frozenframework/Pi4B_HeadUnit/apps/styles/hudiy-bg/after-midnight.jpg

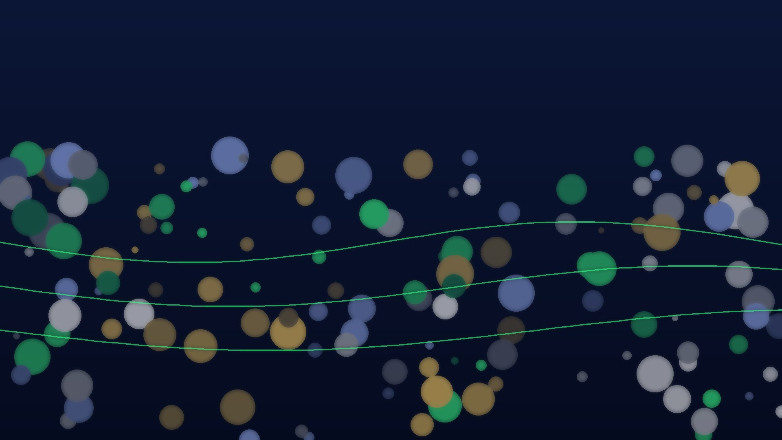
apps/styles/hudiy-bg/after-midnight.jpg
