frozenframework/Pi4B_HeadUnit/apps/styles/hudiy-bg/neon-overdrive.jpg

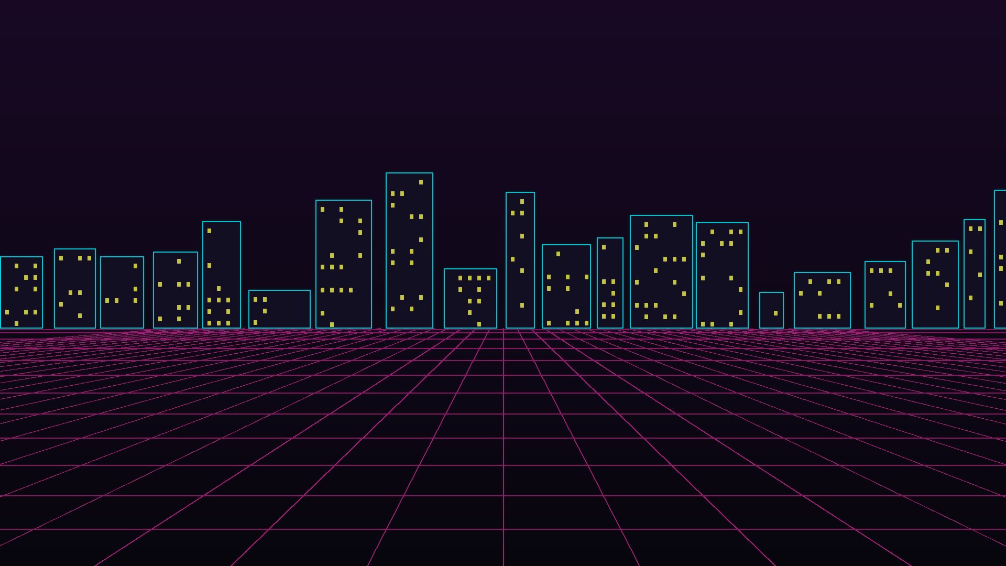
apps/styles/hudiy-bg/neon-overdrive.jpg
