frozenframework/Pi4B_HeadUnit/apps/styles/hudiy-bg/street-heat.jpg

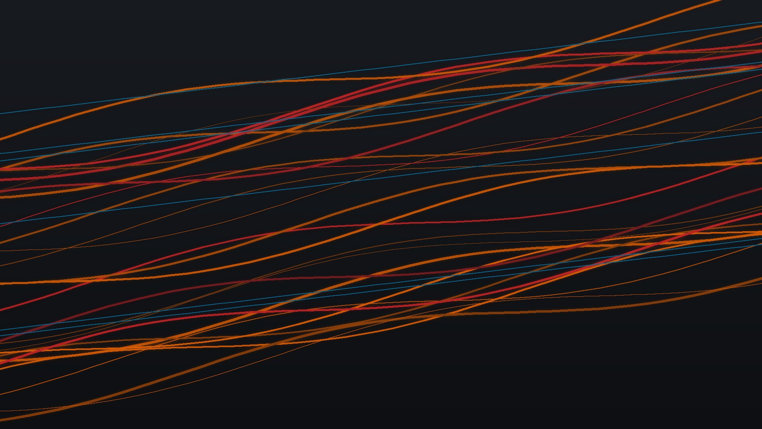
apps/styles/hudiy-bg/street-heat.jpg
