frozenframework/Pi4B_HeadUnit/apps/styles/hudiy-bg/sunset-junction.jpg

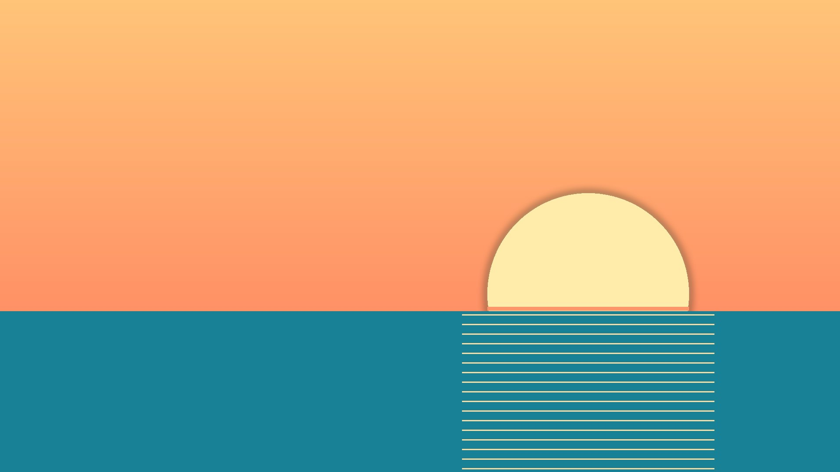
apps/styles/hudiy-bg/sunset-junction.jpg
