frozenframework/Pi4B_HeadUnit/apps/theme/previews/after-midnight.png

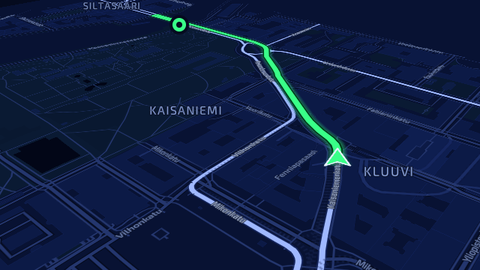
apps/theme/previews/after-midnight.png
