frozenframework/Pi4B_HeadUnit/apps/theme/previews/neon-overdrive.png

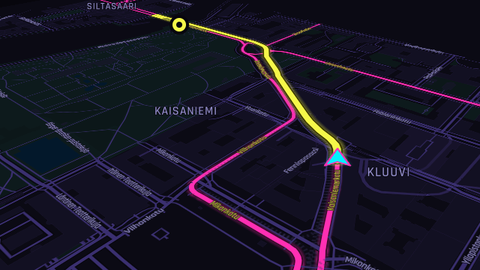
apps/theme/previews/neon-overdrive.png
