frozenframework/Pi4B_HeadUnit/apps/theme/previews/street-heat.png

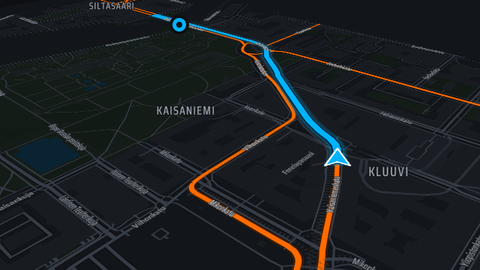
apps/theme/previews/street-heat.png
