frozenframework/Pi4B_HeadUnit/apps/theme/previews/sunset-junction.png

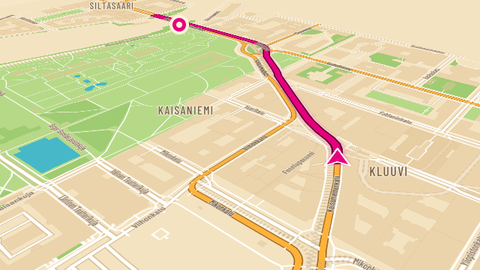
apps/theme/previews/sunset-junction.png
