frozenframework/Pi4B_HeadUnit/docs/Frontier_2DIN_Parts_List.xlsx

Sheet: Summary
2017 Frontier SV: budget tiers
Prices checked 2026-10-30/31. Totals exclude the Pi 4B and microSD you already have.
Tier | Budget target ($) | Parts total ($) | Over (+) / under (-) ($) | What you get
Tier 1 | $100.00 | $246.29 | $146.29 | Double-DIN install, Raspberry Pi Touch Display 2, Android Auto (wired or wireless, built into Hudiy), iPod/USB music, safe-shutdown power, 4-speaker amp. No CarPlay, no camera, no GPS navigation, no wheel buttons.
Tier 2 | $250.00 | $414.23 | $164.23 | Tier 1 plus CarPlay (Carlinkit), the factory backup camera (Axxess adapter + capture stick, shows automatically in reverse), GPS for the themed offline navigation, and a powered USB hub.
Tier 3 | $500.00 | $498.66 | -$1.34 | Your chosen spec: 900-nit Orient Display instead of the Touch Display 2, steering-wheel controls (MCP3008), noise isolation, cooling case and trim tools.
Why Tier 1 can't hit $100: the dash kit ($26.99), harness ($20.49) and the cheapest suitable 7in touchscreen (about $82-88 in 2026) are about $130 before power or audio parts.
Why Tier 2 runs over: CarPlay needs the $65 Carlinkit, and keeping the factory camera is about $64 (Axxess 6 V adapter + USB capture stick + cable).
Biggest levers: skip CarPlay (-$65) or the camera (-$64). The safe-shutdown power latch (about $54) protects the SD card and isn't worth cutting.
Legend: blue = editable input. Green = pulled from another sheet. Red delta = over budget.

Sheet: Frontier Parts
2017 Nissan Frontier SV: double-DIN Pi 4B head unit, three budget tiers
Base audio (no sub), factory camera, Pi already owned. Tier columns: Y = included. ALT / OPT / HAVE rows aren't counted. Blue cells are editable (qty, price, Y flags, budget). Gray Price Basis = estimate.
# | Group | Item | Model / Part # | Why it's needed | Qty | Unit Price ($) | Price Basis | Tier 1 | Tier 2 | Tier 3 | Tier 1 Cost ($) | Tier 2 Cost ($) | Tier 3 Cost ($) | Vendor | URL | Notes
1 | 1. Double-DIN install | Dash kit, single/double-DIN (most 2017 Frontier trims) | Metra 99-7581 | Gives the dash a standard ISO double-DIN opening to anchor the screen bezel and Pi sled. | 1 | $26.99 | Verified 2026-10-30 | Y | Y | Y | $26.99 | $26.99 | $26.99 | OnlineCarStereo (Metra) | https://onlinecarstereo.com/CarAudio/p_22709_Metra_Electronics_99-7581.aspx | The kit for your SV. Listed for Frontier/Pathfinder/Xterra 2005-2017; double-check in Metra's Vehicle Fit Guide when ordering.
2 | 1. Double-DIN install | Radio wiring harness with amp integration + reverse lead | Metra 70-7552 | Plugs into the factory radio plug. Works with the base system and the Rockford Fosgate amplified system, and has a reverse-signal wire for the camera trigger. | 1 | $20.49 | Verified 2026-10-30 | Y | Y | Y | $20.49 | $20.49 | $20.49 | OnlineCarStereo (Metra) | https://onlinecarstereo.com/CarAudio/p_22955_Metra_Electronics_70-7552.aspx | On sale for $10.99 when checked; regular price used. No ground wire: ground to chassis.
3 | 1. Double-DIN install | Radio removal / trim tool set | Generic | Pops the center bezel without marring it. | 1 | $9.00 | Estimate |  |  | Y | $0.00 | $0.00 | $9.00 | Amazon (search) | https://www.amazon.com/s?k=car+trim+removal+tool+kit | Skip if you already own one.
4 | 2. Screen (2-DIN) | 7in 1024x600 HDMI + USB capacitive touch, 900 nits | Orient Display AFY1024600A2-7.0INTH-C-HDMI | Bright enough for a truck dash in Texas sun; rated -20 to 70 C; runs off 12 V directly. | 1 | $107.88 | Verified 2026-10-31 |  |  | Y | $0.00 | $0.00 | $107.88 | Orient Display | https://orientdisplay.com/products/7-0-raspberry-pi-tft-with-pcap-1024x600-900-nits-vga-hdmi-usb-interface/ | Module about 165 x 116 x 12 mm: the printed 2-DIN bezel sits over the kit opening. Measure before printing.
5 | 2. Screen (2-DIN) | Raspberry Pi Touch Display 2 (7in, 720x1280 DSI) | SC1635 | Budget alternative INSTEAD of the Orient Display: official, plugs into the DSI port, powered by the Pi. | 1 | $81.95 | Verified 2026-10-31 | Y | Y |  | $81.95 | $81.95 | $0.00 | PiShop.us | https://www.pishop.us/product/raspberry-pi-touch-display-2/ | Dimmer than 900 nits (brightness not published). 189 x 120 mm outline. Set DISPLAY_TYPE=pi-touch-display-2. Tiers 1-2 screen: DSI ribbon, powered by the Pi; set DISPLAY_TYPE=pi-touch-display-2.
6 | 2. Screen (2-DIN) | Micro-HDMI to HDMI cable, 30 cm, slim | Generic | Pi 4 micro-HDMI to the screen. | 1 | $9.00 | Estimate |  |  | Y | $0.00 | $0.00 | $9.00 | Amazon (search) | https://www.amazon.com/s?k=micro+HDMI+to+HDMI+30cm+slim
7 | 3. Factory backup camera | Backup-camera retention harness with 6 V converter | Axxess AXBUCS-NI326V | Connects the factory Nissan camera to an aftermarket head unit and powers it with the 6 V it needs. | 1 | $42.94 | Verified 2026-10-31 |  | Y | Y | $0.00 | $42.94 | $42.94 | OnlineCarStereo (Axxess) | https://www.onlinecarstereo.com/CarAudio/p_79967_Axxess_AXBUCS-NI326V.aspx | Listed for Frontier 2013-up. Only for trucks that came with a camera (factory screen radio).
8 | 3. Factory backup camera | USB composite-video capture stick (UTV007 / STK1160 chip) | EasyCap-style | The Pi has no video input; this turns the camera's RCA signal into a USB webcam Hudiy can show. | 1 | $15.00 | Estimate |  | Y | Y | $0.00 | $15.00 | $15.00 | Amazon (search) | https://www.amazon.com/s?k=USB+video+capture+UTV007+composite | Pick one that names UTV007 or STK1160 (both have Linux drivers built in).
9 | 3. Factory backup camera | RCA video extension, 1 m | Generic | Camera harness RCA to the capture stick behind the dash. | 1 | $6.00 | Estimate |  | Y | Y | $0.00 | $6.00 | $6.00 | Amazon (search) | https://www.amazon.com/s?k=RCA+video+cable+3ft
10 | 4. Head unit core | Hudiy head-unit license | Hudiy 2.x | CarPlay (via Carlinkit) + Android Auto. One license per vehicle. | 1 | $10.00 | Verified 2026-10-30 | Y | Y | Y | $10.00 | $10.00 | $10.00 | Hudiy | https://hudiy.eu/product/hudiy/
11 | 4. Head unit core | Carlinkit CPC200-CCPA wireless CarPlay / Android Auto adapter | CPC200-CCPA | Required for CarPlay. | 1 | $65.00 | Verified 2026-10-30 |  | Y | Y | $0.00 | $65.00 | $65.00 | Carlinkit | https://carlinkitcarplay.com/products/carlinkit-wirless-adapter-for-android-head-unit-support-carplay-and-android-auto
12 | 5. Power | 12V to 5V 5A step-down, USB-C | Generic | Pi power. | 1 | $14.00 | Estimate | Y | Y | Y | $14.00 | $14.00 | $14.00 | Amazon (search) | https://www.amazon.com/s?k=12V+to+5V+5A+USB-C+step+down+converter | 8-36 V input range.
13 | 5. Power | 12V 40A SPDT relay with socket | Bosch-style | Main power latch (key on / Pi holds until clean shutdown). | 1 | $8.00 | Estimate | Y | Y | Y | $8.00 | $8.00 | $8.00 | Amazon (search) | https://www.amazon.com/s?k=12V+40A+SPDT+relay+socket+harness
14 | 5. Power | 4-channel 5V relay module, HIGH-level trigger | Generic | CH1 power hold, CH2 amp remote, CH3 antenna-amp feed, CH4 spare. | 1 | $9.00 | Estimate | Y | Y | Y | $9.00 | $9.00 | $9.00 | Amazon (search) | https://www.amazon.com/s?k=4+channel+5V+relay+module+optocoupler+high+level+trigger
15 | 5. Power | 4-channel optocoupler module, 12V in / 3.3V out | PC817 based | ACC (ignition), dash lights, REVERSE (camera trigger), spare. The Frontier needs the extra reverse channel. | 1 | $9.00 | Estimate | Y | Y | Y | $9.00 | $9.00 | $9.00 | Amazon (search) | https://www.amazon.com/s?k=PC817+4+channel+optocoupler+isolation+module+12V+3.3V | Replaces the 2-channel module used in the F-250/Miata lists.
16 | 5. Power | 1N4007 diode pack + inline ATC fuse holders | Generic | Diode-OR for the relay coil; fuse every 12 V feed. | 1 | $14.00 | Estimate | Y | Y | Y | $14.00 | $14.00 | $14.00 | Amazon (search) | https://www.amazon.com/s?k=inline+ATC+fuse+holder+16AWG+kit
17 | 6. Audio | USB audio adapter (3.5 mm out) | Adafruit 1475 | Clean line out to the amp. | 1 | $4.95 | Verified 2026-10-30 | Y | Y | Y | $4.95 | $4.95 | $4.95 | Adafruit | https://www.adafruit.com/product/1475
18 | 6. Audio | TPA3116D2 2x50W amp board | Parts Express 320-699 | Your SV has the base (non-Rockford) audio: the two boards drive the 4 door speakers directly. | 2 | $13.98 | Verified 2026-10-30 | Y | Y | Y | $27.96 | $27.96 | $27.96 | Parts Express | https://parts-express.com/TPA3116D2-2x50W-Class-D-Stereo-Amplifier-Board-with-Volume-Control-320-699 | Print an ASA enclosure; the 2-DIN sled has room for both boards.
19 | 6. Audio | RCA Y-splitter pair | Generic | Front + rear from one stereo output. | 1 | $6.00 | Estimate | Y | Y | Y | $6.00 | $6.00 | $6.00 | Amazon (search) | https://www.amazon.com/s?k=RCA+Y+splitter+1+female+2+male
20 | 6. Audio | Ground loop noise isolator | Generic | Kills alternator whine. | 1 | $10.00 | Estimate |  |  | Y | $0.00 | $0.00 | $10.00 | Amazon (search) | https://www.amazon.com/s?k=ground+loop+noise+isolator+car+audio
21 | 6. Audio | Mini USB microphone | Adafruit 3367 | Siri / Google Assistant / calls. | 1 | $5.95 | Verified 2026-10-30 | Y | Y | Y | $5.95 | $5.95 | $5.95 | Adafruit | https://www.adafruit.com/product/3367
22 | 7. Nav, media, cooling | USB GPS receiver (u-blox 7) | VK-162 | Themed offline navigation. | 1 | $14.00 | Estimate |  | Y | Y | $0.00 | $14.00 | $14.00 | Amazon (search) | https://www.amazon.com/s?k=VK-162+USB+GPS
23 | 7. Nav, media, cooling | Powered USB 2.0 hub (5 V input) | Generic | Dongle, GPS, capture stick, iPod, mic exceed the Pi's 1.2 A USB budget. | 1 | $15.00 | Estimate |  | Y | Y | $0.00 | $15.00 | $15.00 | Amazon (search) | https://www.amazon.com/s?k=powered+USB+2.0+hub+5V+DC+input+4+port
24 | 7. Nav, media, cooling | 12V to 5V 3A step-down (hub feed) | Generic | Powers the USB hub. | 1 | $10.00 | Estimate |  | Y | Y | $0.00 | $10.00 | $10.00 | Amazon (search) | https://www.amazon.com/s?k=12V+to+5V+3A+step+down+converter+module | The Orient Display runs on 12 V, so this only feeds the hub.
25 | 7. Nav, media, cooling | USB panel-mount extension (iPod / USB stick) | Generic | Front-accessible USB for the iPod. | 1 | $8.00 | Estimate | Y | Y | Y | $8.00 | $8.00 | $8.00 | Amazon (search) | https://www.amazon.com/s?k=USB+2.0+panel+mount+extension+cable+female
26 | 7. Nav, media, cooling | Pi 4 heatsink case with fan | Armor-style | Cooling in a hot dash. | 1 | $10.00 | Estimate |  |  | Y | $0.00 | $0.00 | $10.00 | Amazon (search) | https://www.amazon.com/s?k=Raspberry+Pi+4+aluminum+armor+case+fan
27 | 8. Steering-wheel controls | MCP3008 8-channel 10-bit ADC | Adafruit 856 | Reads the wheel's resistor-ladder buttons. hu-swc.py learns your buttons and sends volume/track/phone actions to Hudiy. | 1 | $4.50 | Verified 2026-10-31 |  |  | Y | $0.00 | $0.00 | $4.50 | Adafruit | https://www.adafruit.com/product/856 | SPI bus (GPIO 8-11): no clash with the ignition, reverse or power pins.
28 | 8. Steering-wheel controls | 1 kOhm 1/4 W resistor assortment | Generic | Pull-up for each wheel key wire (one per channel used). | 1 | $6.00 | Estimate |  |  | Y | $0.00 | $0.00 | $6.00 | Amazon (search) | https://www.amazon.com/s?k=1k+ohm+resistor+1/4W+pack
29 | 8. Steering-wheel controls | Proto HAT / perfboard for the ADC + resistors | Adafruit Perma-Proto HAT or generic | Solid mount for the MCP3008, pull-ups and the opto board connections on the Pi header. | 1 | $10.00 | Estimate |  |  | Y | $0.00 | $0.00 | $10.00 | Amazon (search) | https://www.amazon.com/s?k=Raspberry+Pi+proto+HAT+perfboard | Leave the CarPiHAT out on this truck; this board uses the same header.
 |  |  |  |  |  |  |  |  |  | Tier total | $246.29 | $414.23 | $498.66
 |  |  |  |  |  |  |  |  |  | Budget target | $100.00 | $250.00 | $500.00
 |  |  |  |  |  |  |  |  |  | Over (+) / under (-) | $146.29 | $164.23 | -$1.34
Alternatives, optional add-ons and parts you already have (not counted)
# | Group | Item | Model / Part # | Why | Qty | Unit Price ($) | Price Basis | Status | URL | Notes
1 | 1. Double-DIN install | Dash kit, double-DIN (SL with Comfort & Convenience pkg - NOT your SV) | Metra 95-7619 | Not for your SV. Listed for reference: SL with Comfort & Convenience package only. | 1 | $29.99 | Verified 2026-10-31 | ALT | https://www.soundoftristate.com/metra-95-7619 | Metra lists this kit for 2013+ Frontier SL with comfort & convenience package only.
2 | 1. Double-DIN install | Antenna adapter (Nissan 2007+) | Metra 40-NI12 | Factory antenna plug to the standard Motorola plug (for the RTL-SDR radio adapter if you add AM/FM). | 1 | $9.99 | Verified 2026-10-31 | OPT | https://www.qualitymobilevideo.com/40-ni12.html | Only needed if you add the AM/FM tuner (RTL-SDR).
3 | 4. Head unit core | Raspberry Pi 4 Model B, 4 GB | SC0195 | You have a third Pi 4: not counted. | 1 | $80.00 | Estimate | HAVE | https://www.pishop.us/product/raspberry-pi-4-model-b-4gb/ | Price rose in 2026 (memory costs): about $55 + $25.
4 | 4. Head unit core | 32 GB microSD (you have) or 256 GB High Endurance for whole-US maps | SanDisk SDSQQNR-256G | Texas + neighbors fits on 32 GB; whole US needs the 256 GB card. | 1 | $25.00 | Estimate | OPT | https://www.amazon.com/s?k=SanDisk+High+Endurance+256GB+microSD
5 | 8. Optional | AM/FM: RTL-SDR Blog V4 + Motorola-to-SMA adapter | R828D | Adds AM/FM like the F-250 tier 3. | 1 | $49.00 | Estimate | OPT | https://www.rtl-sdr.com/product/rtl-sdr-blog-v4-r828d-rtl2832u-1ppm-tcxo-sma-software-defined-radio-dongle-only-usb-c/ | Needs the Metra 40-NI12 too.

Sheet: Wiring Frontier
Wiring: Metra 70-7552 harness, factory camera, Pi GPIO
Metra's colors follow the EIA standard. The 70-7552 sheet lists its extra leads (amp integration, reverse, steering wheel): confirm each with a meter (key off, key on, in reverse, lights on).
Harness wire | Function | Connects to (head unit side) | Fuse / gauge | Notes
Yellow | +12 V constant | Fuse 7.5 A -> main relay pin 30 and relay-module CH1 COM (power hold) | 7.5 A, 16 AWG
Red | +12 V accessory | Diode D1 -> main relay coil 86; optocoupler CH1 -> GPIO3 (ACC sense + wake) | 2 A, 18 AWG
Black / chassis | Ground | Relay 85, converters, amp boards, screen | 16 AWG | Harness has no ground wire: bolt to bare chassis metal behind the dash.
Orange (or Orange/White) | Dash illumination | Optocoupler CH2 -> GPIO4 (night dimming) | 1 A, 18 AWG
Reverse lead (see 70-7552 sheet) | +12 V in reverse | Optocoupler CH3 -> GPIO5 -> Hudiy shows the camera | 1 A, 18 AWG | If the harness lead is dead in reverse, tap the reverse-light feed instead.
Blue/White | Amp turn-on | Not needed on your SV (no factory amp): leave capped | - | The TPA boards switch with the relay instead.
Blue | Antenna amp power | Relay 87 switched 12 V (always on with the head unit) | 1 A, 18 AWG | Powers the antenna amplifier on Nissans; only matters for AM/FM.
TPA3116 board power | 12 V for the amp boards | Relay 87 switched 12 V via 5 A fuse | 5 A, 16 AWG | Boards power up only after the Pi has booted (relay CH2), so no turn-on pop.
White / White-Black | Left front + / - | Amp CH1 L | 18 AWG
Gray / Gray-Black | Right front + / - | Amp CH1 R | 18 AWG
Green / Green-Black | Left rear + / - | Amp CH2 L | 18 AWG | Crew cab rear doors.
Violet / Violet-Black | Right rear + / - | Amp CH2 R | 18 AWG
Steering-wheel key wires (70-7552 SWC leads) | Resistor-ladder buttons | Each key wire -> MCP3008 CH0, CH1... and a 1 kOhm pull-up to 3.3 V | - | Find them with a meter: resistance to the wheel-control ground changes as you press buttons. Then run hu-swc.py --raw to check, --learn to record.
Steering-wheel ground | Ladder return | Pi GND | - | Must share ground with the Pi, or the readings drift.
MCP3008 VDD + VREF | ADC supply / reference | Pi 3.3 V (pin 1) | - | 3.3 V reference = same rail as the pull-ups, so readings stay ratiometric.
MCP3008 CLK / DOUT / DIN / CS | SPI | GPIO11 (pin 23) / GPIO9 (pin 21) / GPIO10 (pin 19) / GPIO8 (pin 24) | - | dtparam=spi=on is set by setup stage 77-swc.
Axxess AXBUCS-NI326V | Factory camera | Camera plug -> harness; 6 V converter powered from the REVERSE lead; RCA video -> USB capture stick | - | Camera gets power only in reverse, same as the factory radio did.
Pi GPIO3 (pin 5) | ACC sense / wake | Optocoupler CH1 output | -
Pi GPIO4 (pin 7) | Dash lights | Optocoupler CH2 output | -
Pi GPIO5 (pin 29) | Reverse | Optocoupler CH3 output | - | New for the Frontier.
Pi GPIO26 (pin 37) | Power hold | Relay module IN1 | - | gpio-poweroff overlay
Pi GPIO27 (pin 13) | Amp remote | Relay module IN2 | -
Orient Display 12 V | Screen power | Relay 87 switched 12 V via 2 A fuse | 2 A, 18 AWG | This screen runs on 12 V directly.

Sheet: Your answers
Your answers (2026-10-31) and what they changed
Trim: SV | Dash kit Metra 99-7581 (the 95-7619 is SL-only). SV has wheel audio buttons: steering-wheel parts added.
Rockford Fosgate: no (no sub) | Base audio: amp boards drive the 4 door speakers directly; harness amp-integration and amp turn-on leads stay unused.
Factory camera: yes | Axxess AXBUCS-NI326V + USB capture stick; camera shows automatically in reverse.
Screen: 900-nit Orient Display | Runs on 12 V; printed 2-DIN bezel (cad/print/2din-7in). Measure the module before printing.
Steering-wheel controls: yes | MCP3008 + 1 kOhm pull-ups; run hu-swc.py --learn once with the key on.
Third Pi 4: already have | Pi not counted in the total.
