frozenframework/Pi4B_HeadUnit/docs/Pi_HeadUnit_Parts_List.xlsx

Sheet: Summary
Pi 4B CarPlay / Android Auto head unit: budget summary
Prices checked 2026-10-30. Gray 'Estimate' cells are typical street prices that still need a final check. Totals exclude the Pi 4B and the 32GB card you already own.
Vehicle | Tier | Budget target ($) | Parts total ($) | Over (+) / under (-) ($) | What you get
1997 Ford F-250 7.3L (crew cab, 4 speakers) | Tier 1 | $100.00 | $232.15 | $132.15 | Android Auto (wired or wireless, native in Hudiy), iPod/USB music, safe-shutdown power latch, budget amp. No CarPlay, no GPS navigation, no AM/FM.
1997 Ford F-250 7.3L (crew cab, 4 speakers) | Tier 2 | $250.00 | $336.15 | $86.15 | Everything in Tier 1 plus CarPlay (Carlinkit), the themed offline navigation with GPS, a powered USB hub and noise isolation. Maps: Texas plus neighboring states on the 32GB card.
1997 Ford F-250 7.3L (crew cab, 4 speakers) | Tier 3 | $500.00 | $532.09 | $32.09 | CarPiHAT power board, RCA line-out DAC, a real car amp, better GPS, AM/FM radio and a 256GB card with whole-US maps.
1997 Mazda Miata (2 door speakers) | Tier 1 | $100.00 | $212.17 | $112.17 | Android Auto (wired or wireless, native in Hudiy), iPod/USB music, safe-shutdown power latch, budget amp. No CarPlay, no GPS navigation, no AM/FM.
1997 Mazda Miata (2 door speakers) | Tier 2 | $250.00 | $316.17 | $66.17 | Everything in Tier 1 plus CarPlay (Carlinkit), the themed offline navigation with GPS, a powered USB hub and noise isolation. Maps: Texas plus neighboring states on the 32GB card.
1997 Mazda Miata (2 door speakers) | Tier 3 | $500.00 | $506.09 | $6.09 | CarPiHAT power board, RCA line-out DAC, a real car amp, better GPS, AM/FM radio and a 256GB card with whole-US maps.
 |  | Both vehicles, Tier 3 | $1038.18
 |  | Shared tools | $153.99
Why Tier 1 can't hit $100: the screen ($78.99), Hudiy ($10) and the harness ($18.30) alone are about $107 before any power or audio parts.
Why Tier 2 runs over: CarPlay needs the $65 Carlinkit dongle, and a safe-shutdown power latch is about $45 of parts. Both are non-negotiable for an iPhone and SD-card safety.
Biggest levers: drop CarPlay (-$65), drop GPS navigation (-$14), share one 5V converter at lower screen brightness (-$10).
Legend: blue text = editable input (qty, price, tier Y flags, budget). Gray 'Price Basis' = estimate. Green = value pulled from another sheet.

Sheet: F-250 Parts
F-250 Parts parts list: Raspberry Pi 4B CarPlay / Android Auto head unit
Excludes the Pi 4B (4GB) and 32GB card you already own. Mark a part 'Y' in a tier column to include it. Blue = editable inputs; Y/blank flags are inputs too.
# | Category | Item | Model / Part # | Why it's needed | Qty | Unit Price ($) | Price Basis | Tier 1 | Tier 2 | Tier 3 | Tier 1 Cost ($) | Tier 2 Cost ($) | Tier 3 Cost ($) | Vendor | URL | Notes
1 | Display | Waveshare 7.9in HDMI capacitive touch LCD (1280x400 when rotated) | SKU 17916 | Main screen. Native 400x1280 portrait; rotated 90 deg in software. HDMI video + USB touch = plug and play. | 1 | $78.99 | Verified 2026-10-30 | Y | Y | Y | $78.99 | $78.99 | $78.99 | Waveshare | https://www.waveshare.com/7.9inch-hdmi-lcd.htm | Also sold by PiShop.us ($85.95). Needs its own 5V/2A feed at high brightness (see screen buck converter).
2 | Software | Hudiy head-unit license | Hudiy 2.x (Trixie) | Runs Android Auto (wired/wireless) natively and CarPlay through the Carlinkit dongle. One license per vehicle. | 1 | $10.00 | Verified 2026-10-30 | Y | Y | Y | $10.00 | $10.00 | $10.00 | Hudiy (Wiboma) | https://hudiy.eu/product/hudiy/ | One-time payment, personal use, one running instance per license.
3 | Wiring | Radio harness adapter (plugs into factory radio connector) | Metra 70-1770 | Lets the head unit wiring plug into the factory radio plug with no cutting of the vehicle harness. | 1 | $18.30 | Verified 2026-10-30 | Y | Y | Y | $18.30 | $18.30 | $18.30 | OnlineCarStereo (Metra) | https://onlinecarstereo.com/CarAudio/p_22877_Metra_Electronics_70-1770.aspx | Ford 1985-2004. Listed on sale for $5.99 but out of stock; regular price used. Metra's 95-5701 page also names 70-1770 for 1992-96 F-Series.
4 | Phone | Carlinkit CPC200-CCPA wireless CarPlay / Android Auto adapter | CPC200-CCPA | Required for CarPlay: Apple needs an authentication chip the Pi does not have. Also does wireless Android Auto. | 1 | $65.00 | Verified 2026-10-30 |  | Y | Y | $0.00 | $65.00 | $65.00 | Carlinkit | https://carlinkitcarplay.com/products/carlinkit-wirless-adapter-for-android-head-unit-support-carplay-and-android-auto | Pair your iPhone once; passenger Android phones can use Hudiy's native Android Auto.
5 | Power | 12V to 5V 5A step-down converter, USB-C output | Generic (DROK or similar) | Powers the Pi 4 (needs a stable 5.1V/3A). | 1 | $14.00 | Estimate | Y | Y |  | $14.00 | $14.00 | $0.00 | Amazon (search) | https://www.amazon.com/s?k=12V+to+5V+5A+USB-C+step+down+converter | Pick one rated for 8-36V input so cranking dips and 14.4V charging are both in range.
6 | Power | 12V 40A SPDT automotive relay with socket | Bosch-style 5-pin | Main power latch: ACC turns it on; the Pi holds it on until it has shut down safely. | 1 | $8.00 | Estimate | Y | Y |  | $8.00 | $8.00 | $0.00 | Amazon (search) | https://www.amazon.com/s?k=12V+40A+SPDT+relay+socket+harness
7 | Power | 4-channel 5V relay module, opto-isolated, HIGH-level trigger | Generic | CH1 power hold, CH2 amp remote turn-on, CH3 power antenna, CH4 spare. | 1 | $9.00 | Estimate | Y | Y |  | $9.00 | $9.00 | $0.00 | Amazon (search) | https://www.amazon.com/s?k=4+channel+5V+relay+module+optocoupler+high+level+trigger | Must be HIGH-level trigger so relays are off while the Pi boots.
8 | Power | 2-channel optocoupler isolation module, 12V in / 3.3V out | PC817 based | CH1 ACC (ignition) sense on GPIO3, which also wakes the Pi; CH2 dash-light sense for night mode. | 1 | $7.00 | Estimate | Y | Y |  | $7.00 | $7.00 | $0.00 | Amazon (search) | https://www.amazon.com/s?k=PC817+optocoupler+isolation+module+12V+to+3.3V+2+channel | Keeps 12V away from the Pi's 3.3V GPIO pins.
9 | Power | 1N4007 diode pack | 1N4007 | Diode-OR for the relay coil (ACC and Pi hold) so neither back-feeds the other. | 1 | $5.00 | Estimate | Y | Y |  | $5.00 | $5.00 | $0.00 | Amazon (search) | https://www.amazon.com/s?k=1N4007+diode+pack
10 | Power | CarPiHAT (car interface HAT for Pi 4) | TJD CarPiHAT | 12V-to-5V supply, ignition-sense safe shutdown, CAN port and 12V outputs on one board. Replaces the DIY power parts. | 1 | $97.00 | Estimate |  |  | Y | $0.00 | $0.00 | $97.00 | The Pi Hut (UK) | https://thepihut.com/products/carpihat-car-interface-hat-for-raspberry-pi | Listed at GBP 73 (HAT only). USD is an estimate before shipping/import. Confirm pin assignments from TJD's manual before wiring.
11 | Audio | USB audio adapter (3.5mm out) | Adafruit 1475 | Clean audio out to the amp (the Pi 4 headphone jack is noisy). | 1 | $4.95 | Verified 2026-10-30 | Y | Y |  | $4.95 | $4.95 | $0.00 | Adafruit | https://www.adafruit.com/product/1475
12 | Audio | Behringer UCA202 USB audio interface (RCA line out) | UCA202 | RCA line-level out straight into the amp's inputs: less noise than a 3.5mm dongle. | 1 | $24.90 | Verified 2026-10-30 |  |  | Y | $0.00 | $0.00 | $24.90 | Sweetwater | https://www.sweetwater.com/store/detail/UCA202--behringer-u-control-uca202-usb-audio-interface | Backordered at Sweetwater (est. Jan 2027); widely stocked elsewhere.
13 | Audio | Ground loop noise isolator | 3.5mm/RCA | Kills alternator whine between the Pi/USB audio and the amp. | 1 | $10.00 | Estimate |  | Y | Y | $0.00 | $10.00 | $10.00 | Amazon (search) | https://www.amazon.com/s?k=ground+loop+noise+isolator+car+audio | Diesel alternators are noisy. Add it if you hear whine.
14 | Audio | TPA3116D2 2x50W class-D amp board | Parts Express 320-699 | Budget amplifier powered from 12V. One board drives 2 speakers. | 2 | $13.98 | Verified 2026-10-30 | Y | Y |  | $27.96 | $27.96 | $0.00 | Parts Express | https://parts-express.com/TPA3116D2-2x50W-Class-D-Stereo-Amplifier-Board-with-Volume-Control-320-699 | Backordered at Parts Express; common item elsewhere. Print an ASA enclosure; it needs airflow. No remote input: power it from relay CH2.
15 | Audio | BOSS Audio R1004 4-channel amplifier (4x38W RMS @ 4 ohm) | R1004 | A real 4-channel car amp with RCA inputs and a remote turn-on for the crew cab's 4 speakers. | 1 | $60.00 | Estimate |  |  | Y | $0.00 | $0.00 | $60.00 | Parts Express | https://parts-express.com/BOSS-R1004-RIOT-400-Watt-4-Ch-Amplifier-265-3987 | Size 9 x 2 x 10.6 in: mount it under the rear seat. Power it from the battery with its own fuse.
16 | Audio | RCA Y-splitter pair (1 female to 2 male) | Generic | Feeds front and rear amp channels from one stereo output. | 1 | $6.00 | Estimate | Y | Y | Y | $6.00 | $6.00 | $6.00 | Amazon (search) | https://www.amazon.com/s?k=RCA+Y+splitter+1+female+2+male
17 | Power | 12V to 5V 3A step-down converter (screen + USB hub feed) | Generic | The Pi's USB ports share 1.2A total, which is not enough for the screen backlight, dongle, iPod and GPS together. | 1 | $10.00 | Estimate | Y | Y | Y | $10.00 | $10.00 | $10.00 | Amazon (search) | https://www.amazon.com/s?k=12V+to+5V+3A+step+down+converter+module
18 | Power | Inline ATC fuse holders + assorted fuses | ATC/ATO | Fuse every 12V feed at its source (Pi feed 5A, amp per its manual). | 1 | $9.00 | Estimate | Y | Y | Y | $9.00 | $9.00 | $9.00 | Amazon (search) | https://www.amazon.com/s?k=inline+ATC+fuse+holder+16AWG+kit
19 | Audio | Mini USB microphone | Adafruit 3367 | Siri, Google Assistant and hands-free calls. | 1 | $5.95 | Verified 2026-10-30 | Y | Y | Y | $5.95 | $5.95 | $5.95 | Adafruit | https://www.adafruit.com/product/3367 | Mount near the headliner/A-pillar later with a USB extension for better pickup.
20 | Nav | USB GPS receiver (u-blox 7) | VK-162 G-Mouse | Position for the themed offline navigation; Hudiy can also pass it to Android Auto through gpsd. | 1 | $14.00 | Estimate |  | Y |  | $0.00 | $14.00 | $0.00 | Amazon (search) | https://www.amazon.com/s?k=VK-162+USB+GPS | Magnetic puck: mount on top of the dash, out of view of metal.
21 | Media | USB 2.0 panel-mount extension (iPod / USB passthrough port) | 30-50 cm, USB-A female | Front-accessible USB port for the iPod Nano (data + charging) or a USB stick. | 1 | $8.00 | Estimate | Y | Y | Y | $8.00 | $8.00 | $8.00 | Amazon (search) | https://www.amazon.com/s?k=USB+2.0+panel+mount+extension+cable+female | Use your Apple 30-pin cable (Nano 1st-6th gen) or a Lightning cable (7th gen).
22 | Power | Powered USB 2.0 hub (5V DC input) | 4-port, external 5V input | Feeds the dongle, GPS, SDR and iPod from the 3A converter instead of the Pi. | 1 | $15.00 | Estimate |  | Y | Y | $0.00 | $15.00 | $15.00 | Amazon (search) | https://www.amazon.com/s?k=powered+USB+2.0+hub+5V+DC+input+4+port
23 | Cooling | Pi 4 aluminum heatsink case with fan | Armor-style case | Keeps the Pi 4 from throttling in a hot Texas dash. | 1 | $10.00 | Estimate | Y | Y | Y | $10.00 | $10.00 | $10.00 | Amazon (search) | https://www.amazon.com/s?k=Raspberry+Pi+4+aluminum+armor+case+fan | The printed Pi tray has strap slots for this case. Alternative: bare board with stick-on heatsinks on the tray standoffs, cooled through the sled's vent slots.
24 | Nav | Adafruit Ultimate GPS GNSS USB (10 Hz) | Adafruit 4279 | More accurate/faster GPS than the VK-162; smoother map tracking. | 1 | $29.95 | Verified 2026-10-30 |  |  | Y | $0.00 | $0.00 | $29.95 | Adafruit | https://www.adafruit.com/product/4279 | Replaces the VK-162 in tier 3.
25 | Radio | RTL-SDR Blog V4 (dongle only) | R828D / RTL2832U | AM and FM radio. Hudiy does FM with RDS; my add-on app does AM. | 1 | $40.00 | Estimate |  |  | Y | $0.00 | $0.00 | $40.00 | RTL-SDR Blog | https://www.rtl-sdr.com/product/rtl-sdr-blog-v4-r828d-rtl2832u-1ppm-tcxo-sma-software-defined-radio-dongle-only-usb-c/ | The V4's built-in upconverter covers the AM broadcast band.
26 | Radio | Motorola female to SMA male antenna adapter | Generic | Connects the factory AM/FM antenna plug to the RTL-SDR. | 1 | $9.00 | Estimate |  |  | Y | $0.00 | $0.00 | $9.00 | Amazon (search) | https://www.amazon.com/s?k=Motorola+female+to+SMA+male+car+antenna+adapter
27 | Storage | SanDisk High Endurance 256GB microSD | SDSQQNR-256G-GN6IA | Room for whole-US offline maps and routing data (est. 30-45 GB) plus the OS. | 1 | $25.00 | Estimate |  |  | Y | $0.00 | $0.00 | $25.00 | Amazon (search) | https://www.amazon.com/s?k=SanDisk+High+Endurance+256GB+microSD | Tiers 1-2 keep your existing 32GB card with Texas + neighboring states.
 |  |  |  |  |  |  |  |  |  | Tier total | $232.15 | $336.15 | $532.09
 |  |  |  |  |  |  |  |  |  | Budget target | $100.00 | $250.00 | $500.00
 |  |  |  |  |  |  |  |  |  | Over (+) / under (-) | $132.15 | $86.15 | $32.09
Optional / reference parts (not counted in any tier)
# | Category | Item | Model / Part # | Why | Qty | Unit Price ($) | Price Basis | URL | Notes
1 | Dash kit (optional) | Metra 99-5512 Ford single-DIN multi-kit 1988-2000 | 99-5512 | Only if the factory opening needs a DIN cage to anchor your bracket. Not counted in tiers. | 1 |  | Check price | https://metraonline.com/product/99-5512 | Confirm fit with Metra's Vehicle Fit Guide for a 1997 F-250 HD (OBS).
2 | Dash kit (optional) | Metra 95-5701 F-Series 1992-1997 double-DIN kit | 95-5701 | Reference only: double-DIN alternative. Not used with the single-DIN plan. | 1 | $63.99 | Verified 2026-10-30 | https://www.onlinecarstereo.com/CarAudio/p_83588_Metra_Electronics_95-5701.aspx
3 | Amp upgrade | Alpine KTA-450 4-ch power pack (4x50W RMS, 3.5 x 1.75 x 3.75 in) | KTA-450 | Tiny high-quality amp that can hide behind the dash. Upgrade over the BOSS R1004. | 1 | $299.95 | Verified 2026-10-30 | https://www.worldwidestereo.com/products/alpine-kta-450-4-channel-power-pack-amplifier
4 | Diagnostics | ELM327 OBD-II adapter (USB or Bluetooth) | ELM327 | 1997 is OBD-II. Hudiy's API can query it now, and it's a start toward the digital dash. | 1 | $20.00 | Estimate | https://www.amazon.com/s?k=ELM327+USB+OBD2+adapter

Sheet: Miata Parts
Miata Parts parts list: Raspberry Pi 4B CarPlay / Android Auto head unit
Excludes the Pi 4B (4GB) and 32GB card you already own. Mark a part 'Y' in a tier column to include it. Blue = editable inputs; Y/blank flags are inputs too.
# | Category | Item | Model / Part # | Why it's needed | Qty | Unit Price ($) | Price Basis | Tier 1 | Tier 2 | Tier 3 | Tier 1 Cost ($) | Tier 2 Cost ($) | Tier 3 Cost ($) | Vendor | URL | Notes
1 | Display | Waveshare 7.9in HDMI capacitive touch LCD (1280x400 when rotated) | SKU 17916 | Main screen. Native 400x1280 portrait; rotated 90 deg in software. HDMI video + USB touch = plug and play. | 1 | $78.99 | Verified 2026-10-30 | Y | Y | Y | $78.99 | $78.99 | $78.99 | Waveshare | https://www.waveshare.com/7.9inch-hdmi-lcd.htm | Also sold by PiShop.us ($85.95). Needs its own 5V/2A feed at high brightness (see screen buck converter).
2 | Software | Hudiy head-unit license | Hudiy 2.x (Trixie) | Runs Android Auto (wired/wireless) natively and CarPlay through the Carlinkit dongle. One license per vehicle. | 1 | $10.00 | Verified 2026-10-30 | Y | Y | Y | $10.00 | $10.00 | $10.00 | Hudiy (Wiboma) | https://hudiy.eu/product/hudiy/ | One-time payment, personal use, one running instance per license.
3 | Wiring | Radio harness adapter (plugs into factory radio connector) | Metra 70-7901 | Lets the head unit wiring plug into the factory radio plug with no cutting of the vehicle harness. | 1 | $18.30 | Verified 2026-10-30 | Y | Y | Y | $18.30 | $18.30 | $18.30 | OnlineCarStereo (Metra) | https://www.onlinecarstereo.com/CarAudio/p_22959_Metra_Electronics_70-7901.aspx | Mazda 1990+. The listing does not name the Miata: confirm on Crutchfield's or Metra's vehicle fit guide before ordering.
4 | Phone | Carlinkit CPC200-CCPA wireless CarPlay / Android Auto adapter | CPC200-CCPA | Required for CarPlay: Apple needs an authentication chip the Pi does not have. Also does wireless Android Auto. | 1 | $65.00 | Verified 2026-10-30 |  | Y | Y | $0.00 | $65.00 | $65.00 | Carlinkit | https://carlinkitcarplay.com/products/carlinkit-wirless-adapter-for-android-head-unit-support-carplay-and-android-auto | Pair your iPhone once; passenger Android phones can use Hudiy's native Android Auto.
5 | Power | 12V to 5V 5A step-down converter, USB-C output | Generic (DROK or similar) | Powers the Pi 4 (needs a stable 5.1V/3A). | 1 | $14.00 | Estimate | Y | Y |  | $14.00 | $14.00 | $0.00 | Amazon (search) | https://www.amazon.com/s?k=12V+to+5V+5A+USB-C+step+down+converter | Pick one rated for 8-36V input so cranking dips and 14.4V charging are both in range.
6 | Power | 12V 40A SPDT automotive relay with socket | Bosch-style 5-pin | Main power latch: ACC turns it on; the Pi holds it on until it has shut down safely. | 1 | $8.00 | Estimate | Y | Y |  | $8.00 | $8.00 | $0.00 | Amazon (search) | https://www.amazon.com/s?k=12V+40A+SPDT+relay+socket+harness
7 | Power | 4-channel 5V relay module, opto-isolated, HIGH-level trigger | Generic | CH1 power hold, CH2 amp remote turn-on, CH3 power antenna, CH4 spare. | 1 | $9.00 | Estimate | Y | Y |  | $9.00 | $9.00 | $0.00 | Amazon (search) | https://www.amazon.com/s?k=4+channel+5V+relay+module+optocoupler+high+level+trigger | Must be HIGH-level trigger so relays are off while the Pi boots.
8 | Power | 2-channel optocoupler isolation module, 12V in / 3.3V out | PC817 based | CH1 ACC (ignition) sense on GPIO3, which also wakes the Pi; CH2 dash-light sense for night mode. | 1 | $7.00 | Estimate | Y | Y |  | $7.00 | $7.00 | $0.00 | Amazon (search) | https://www.amazon.com/s?k=PC817+optocoupler+isolation+module+12V+to+3.3V+2+channel | Keeps 12V away from the Pi's 3.3V GPIO pins.
9 | Power | 1N4007 diode pack | 1N4007 | Diode-OR for the relay coil (ACC and Pi hold) so neither back-feeds the other. | 1 | $5.00 | Estimate | Y | Y |  | $5.00 | $5.00 | $0.00 | Amazon (search) | https://www.amazon.com/s?k=1N4007+diode+pack
10 | Power | CarPiHAT (car interface HAT for Pi 4) | TJD CarPiHAT | 12V-to-5V supply, ignition-sense safe shutdown, CAN port and 12V outputs on one board. Replaces the DIY power parts. | 1 | $97.00 | Estimate |  |  | Y | $0.00 | $0.00 | $97.00 | The Pi Hut (UK) | https://thepihut.com/products/carpihat-car-interface-hat-for-raspberry-pi | Listed at GBP 73 (HAT only). USD is an estimate before shipping/import. Confirm pin assignments from TJD's manual before wiring.
11 | Audio | USB audio adapter (3.5mm out) | Adafruit 1475 | Clean audio out to the amp (the Pi 4 headphone jack is noisy). | 1 | $4.95 | Verified 2026-10-30 | Y | Y |  | $4.95 | $4.95 | $0.00 | Adafruit | https://www.adafruit.com/product/1475
12 | Audio | Behringer UCA202 USB audio interface (RCA line out) | UCA202 | RCA line-level out straight into the amp's inputs: less noise than a 3.5mm dongle. | 1 | $24.90 | Verified 2026-10-30 |  |  | Y | $0.00 | $0.00 | $24.90 | Sweetwater | https://www.sweetwater.com/store/detail/UCA202--behringer-u-control-uca202-usb-audio-interface | Backordered at Sweetwater (est. Jan 2027); widely stocked elsewhere.
13 | Audio | Ground loop noise isolator | 3.5mm/RCA | Kills alternator whine between the Pi/USB audio and the amp. | 1 | $10.00 | Estimate |  | Y | Y | $0.00 | $10.00 | $10.00 | Amazon (search) | https://www.amazon.com/s?k=ground+loop+noise+isolator+car+audio | Diesel alternators are noisy. Add it if you hear whine.
14 | Audio | TPA3116D2 2x50W class-D amp board | Parts Express 320-699 | Budget amplifier powered from 12V. One board drives 2 speakers. | 1 | $13.98 | Verified 2026-10-30 | Y | Y |  | $13.98 | $13.98 | $0.00 | Parts Express | https://parts-express.com/TPA3116D2-2x50W-Class-D-Stereo-Amplifier-Board-with-Volume-Control-320-699 | Backordered at Parts Express; common item elsewhere. Print an ASA enclosure; it needs airflow. No remote input: power it from relay CH2.
15 | Audio | BOSS Audio R1002 2-channel amplifier | R1002 | Compact 2-channel amp with RCA inputs and remote turn-on for the 2 door speakers. | 1 | $40.00 | Estimate |  |  | Y | $0.00 | $0.00 | $40.00 | Amazon (search) | https://www.amazon.com/s?k=BOSS+Audio+R1002+2+channel+amplifier | Fits behind the passenger seat or in the trunk.
16 | Power | 12V to 5V 3A step-down converter (screen + USB hub feed) | Generic | The Pi's USB ports share 1.2A total, which is not enough for the screen backlight, dongle, iPod and GPS together. | 1 | $10.00 | Estimate | Y | Y | Y | $10.00 | $10.00 | $10.00 | Amazon (search) | https://www.amazon.com/s?k=12V+to+5V+3A+step+down+converter+module
17 | Power | Inline ATC fuse holders + assorted fuses | ATC/ATO | Fuse every 12V feed at its source (Pi feed 5A, amp per its manual). | 1 | $9.00 | Estimate | Y | Y | Y | $9.00 | $9.00 | $9.00 | Amazon (search) | https://www.amazon.com/s?k=inline+ATC+fuse+holder+16AWG+kit
18 | Audio | Mini USB microphone | Adafruit 3367 | Siri, Google Assistant and hands-free calls. | 1 | $5.95 | Verified 2026-10-30 | Y | Y | Y | $5.95 | $5.95 | $5.95 | Adafruit | https://www.adafruit.com/product/3367 | Mount near the headliner/A-pillar later with a USB extension for better pickup.
19 | Nav | USB GPS receiver (u-blox 7) | VK-162 G-Mouse | Position for the themed offline navigation; Hudiy can also pass it to Android Auto through gpsd. | 1 | $14.00 | Estimate |  | Y |  | $0.00 | $14.00 | $0.00 | Amazon (search) | https://www.amazon.com/s?k=VK-162+USB+GPS | Magnetic puck: mount on top of the dash, out of view of metal.
20 | Media | USB 2.0 panel-mount extension (iPod / USB passthrough port) | 30-50 cm, USB-A female | Front-accessible USB port for the iPod Nano (data + charging) or a USB stick. | 1 | $8.00 | Estimate | Y | Y | Y | $8.00 | $8.00 | $8.00 | Amazon (search) | https://www.amazon.com/s?k=USB+2.0+panel+mount+extension+cable+female | Use your Apple 30-pin cable (Nano 1st-6th gen) or a Lightning cable (7th gen).
21 | Power | Powered USB 2.0 hub (5V DC input) | 4-port, external 5V input | Feeds the dongle, GPS, SDR and iPod from the 3A converter instead of the Pi. | 1 | $15.00 | Estimate |  | Y | Y | $0.00 | $15.00 | $15.00 | Amazon (search) | https://www.amazon.com/s?k=powered+USB+2.0+hub+5V+DC+input+4+port
22 | Cooling | Pi 4 aluminum heatsink case with fan | Armor-style case | Keeps the Pi 4 from throttling in a hot Texas dash. | 1 | $10.00 | Estimate | Y | Y | Y | $10.00 | $10.00 | $10.00 | Amazon (search) | https://www.amazon.com/s?k=Raspberry+Pi+4+aluminum+armor+case+fan | The printed Pi tray has strap slots for this case. Alternative: bare board with stick-on heatsinks on the tray standoffs, cooled through the sled's vent slots.
23 | Nav | Adafruit Ultimate GPS GNSS USB (10 Hz) | Adafruit 4279 | More accurate/faster GPS than the VK-162; smoother map tracking. | 1 | $29.95 | Verified 2026-10-30 |  |  | Y | $0.00 | $0.00 | $29.95 | Adafruit | https://www.adafruit.com/product/4279 | Replaces the VK-162 in tier 3.
24 | Radio | RTL-SDR Blog V4 (dongle only) | R828D / RTL2832U | AM and FM radio. Hudiy does FM with RDS; my add-on app does AM. | 1 | $40.00 | Estimate |  |  | Y | $0.00 | $0.00 | $40.00 | RTL-SDR Blog | https://www.rtl-sdr.com/product/rtl-sdr-blog-v4-r828d-rtl2832u-1ppm-tcxo-sma-software-defined-radio-dongle-only-usb-c/ | The V4's built-in upconverter covers the AM broadcast band.
25 | Radio | Motorola female to SMA male antenna adapter | Generic | Connects the factory AM/FM antenna plug to the RTL-SDR. | 1 | $9.00 | Estimate |  |  | Y | $0.00 | $0.00 | $9.00 | Amazon (search) | https://www.amazon.com/s?k=Motorola+female+to+SMA+male+car+antenna+adapter
26 | Storage | SanDisk High Endurance 256GB microSD | SDSQQNR-256G-GN6IA | Room for whole-US offline maps and routing data (est. 30-45 GB) plus the OS. | 1 | $25.00 | Estimate |  |  | Y | $0.00 | $0.00 | $25.00 | Amazon (search) | https://www.amazon.com/s?k=SanDisk+High+Endurance+256GB+microSD | Tiers 1-2 keep your existing 32GB card with Texas + neighboring states.
 |  |  |  |  |  |  |  |  |  | Tier total | $212.17 | $316.17 | $506.09
 |  |  |  |  |  |  |  |  |  | Budget target | $100.00 | $250.00 | $500.00
 |  |  |  |  |  |  |  |  |  | Over (+) / under (-) | $112.17 | $66.17 | $6.09
Optional / reference parts (not counted in any tier)
# | Category | Item | Model / Part # | Why | Qty | Unit Price ($) | Price Basis | URL | Notes
1 | Dash kit (optional) | Metra 99-7501 Mazda single-DIN kit 1983-1997 | 99-7501 | Only if the opening needs a DIN cage to anchor your bracket. Not counted in tiers. | 1 | $30.99 | Verified 2026-10-30 | https://www.onlinecarstereo.com/CarAudio/p_22694_Metra_Electronics_99-7501.aspx | The listing doesn't name the Miata: verify fit.
2 | Dash kit (optional) | Metra DP-7529 Miata 1994-1997 dash panel (1 or 2 DIN) | DP-7529 | Full textured center panel. Expensive and currently out of stock. | 1 | $201.99 | Verified 2026-10-30 | https://www.onlinecarstereo.com/CarAudio/p_87876_Metra_Electronics_DP-7529.aspx
3 | Amp upgrade | Rockford Fosgate PBR300X2 (100W x 2 RMS) | PBR300X2 | Compact high-quality 2-channel upgrade. | 1 | $237.99 | Verified 2026-10-30 | https://www.onlinecarstereo.com/CarAudio/p_33978_Rockford_Fosgate_PBR300X2.aspx
4 | Diagnostics | ELM327 OBD-II adapter (USB or Bluetooth) | ELM327 | 1996+ Miatas are OBD-II. | 1 | $20.00 | Estimate | https://www.amazon.com/s?k=ELM327+USB+OBD2+adapter

Sheet: Shared Tools & Consumables
Shared tools and consumables (buy once, covers both vehicles; not in tier totals)
# | Item | Why | Qty | Unit Price ($) | Price Basis | Line Cost ($) | URL | Notes
1 | Bambu Lab ASA filament, 1kg (black) | Bezel and Pi sled for both vehicles (about 250-350 g per vehicle). | 1 | $46.99 | Verified 2026-10-30 | $46.99 | https://www.matterhackers.com/store/c/3d-printer-filament/bambu-lab-asa-filament | Black hides layer lines best on a dash. Print on the textured PEI plate.
2 | M3 brass heat-set inserts (M3 x 5.7 mm, 4.6 mm OD) | Threads in the printed parts for the screen, Pi and sled. | 1 | $12.00 | Estimate | $12.00 | https://www.amazon.com/s?k=M3+heat+set+inserts+5.7mm | Hole size in the CAD is 4.0 mm for these inserts.
3 | M3 stainless button-head screw assortment | Screen clamp, Pi standoffs, sled to bracket. | 1 | $12.00 | Estimate | $12.00 | https://www.amazon.com/s?k=M3+button+head+screw+assortment+stainless
4 | M2.5 x 6 mm screws + M2.5 inserts | Pi 4 mounting holes are M2.5. | 1 | $9.00 | Estimate | $9.00 | https://www.amazon.com/s?k=M2.5+heat+set+insert+screw+kit
5 | 18 AWG and 16 AWG automotive TXL wire, 4 colors | Harness build. | 1 | $25.00 | Estimate | $25.00 | https://www.amazon.com/s?k=18+AWG+TXL+automotive+wire+kit | Use 16 AWG for 12V feeds and 18 AWG for signals and speakers.
6 | Heat-shrink butt connectors + ratcheting crimper | Reliable, sealed splices. | 1 | $30.00 | Estimate | $30.00 | https://www.amazon.com/s?k=heat+shrink+butt+connectors+ratcheting+crimper | Crimp, don't twist-and-tape, in a diesel truck.
7 | Adhesive-lined heat shrink assortment | Strain relief and sealing. | 1 | $10.00 | Estimate | $10.00 | https://www.amazon.com/s?k=adhesive+lined+heat+shrink+tubing+kit
8 | Fabric (Tesa) harness tape | Factory-look wrap that doesn't rattle. | 1 | $9.00 | Estimate | $9.00 | https://www.amazon.com/s?k=tesa+51608+harness+tape
 |  |  |  |  | Total | $153.99

Sheet: Wiring F-250
Wiring F-250
Metra 70-1770 colors follow the EIA standard. Always confirm each wire with a meter at the factory plug before connecting: key off, key on and lights on.
Harness wire (Metra/EIA color) | Function | Connects to (head unit side) | Fuse / wire gauge | Notes
Yellow | +12V constant (battery) | Fuse (7.5A) -> main relay pin 30, and 4-ch relay module CH1 COM (power hold). | 7.5A, 16 AWG | Always live. Tier 3: CarPiHAT 12V battery input instead.
Red | +12V accessory (ignition) | 1) Diode D1 -> main relay coil pin 86. 2) Optocoupler CH1 input (ACC sense -> GPIO3). | 2A, 18 AWG | On a Ford the accessory feed drops during cranking. The Pi rides through on the relay hold. Tier 3: CarPiHAT ignition input.
Black (or chassis ground) | Ground | Main relay pin 85, both converters' GND, amp GND (amp to its own chassis point). | 16 AWG | Metra harnesses may not include a ground. Use a clean bolted chassis point and sand to bare metal.
Orange (Orange/White) | Dash illumination (+12V when lights on) | Optocoupler CH2 input -> GPIO4 (night mode / screen dimming). | 1A, 18 AWG | Optional but recommended.
Blue/White | Amp remote turn-on | 4-ch relay module CH2: COM = relay pin 87 (switched 12V), NO -> amp REM. | 1A, 18 AWG | The Pi turns the amp on after audio is up, so there's no turn-on pop.
Blue | Power antenna / antenna amp | 4-ch relay module CH3: COM = relay pin 87, NO -> blue wire. | 1A, 18 AWG | Raised only while the radio app is playing.
(none) | Main relay pin 87 (switched 12V) | -> 5V 5A converter (Pi), -> 5V 3A converter (screen + USB hub), -> TPA3116 boards (tiers 1-2). | 15A, 16 AWG | Tier 3 amps get their own fused feed from the battery.
(none) | Power hold | 4-ch relay CH1: COM = fused constant 12V, NO -> diode D2 -> relay coil pin 86. | - | Driven by GPIO26 through the gpio-poweroff overlay: the hold stays on until the Pi has fully halted.
White / White-Black | Left front speaker + / - | Amp CH1 L out | 18 AWG | F-250 crew cab front (dash) speakers.
Gray / Gray-Black | Right front speaker + / - | Amp CH1 R out | 18 AWG
Green / Green-Black | Left rear speaker + / - | Amp CH2 L out | 18 AWG | Crew cab rear speakers.
Violet / Violet-Black | Right rear speaker + / - | Amp CH2 R out | 18 AWG
Pi GPIO3 (pin 5) | ACC sense (active low) + wake | Optocoupler CH1 output | - | Opto pulls it low when ACC is on. A low GPIO3 also wakes a halted Pi 4. Keep I2C off in tiers 1-2.
Pi GPIO4 (pin 7) | Dash-light sense (active low) | Optocoupler CH2 output | -
Pi GPIO26 (pin 37) | Power hold | 4-ch relay module IN1 | - | dtoverlay=gpio-poweroff,gpiopin=26,active_low=1
Pi GPIO27 (pin 13) | Amp remote | 4-ch relay module IN2 | -
Pi GPIO22 (pin 15) | Power antenna | 4-ch relay module IN3 | -
Pi GPIO23 (pin 16) | Spare (reverse camera / future) | 4-ch relay module IN4 | -
Pi 5V (pin 2) / GND (pin 6) | Relay and opto module logic power | Module VCC / GND | - | About 70 mA per energized relay.

Sheet: Wiring Miata
Wiring Miata
Metra 70-7901 colors follow the EIA standard. Confirm each wire with a meter at the factory plug before connecting.
Harness wire (Metra/EIA color) | Function | Connects to (head unit side) | Fuse / wire gauge | Notes
Yellow | +12V constant (battery) | Fuse (7.5A) -> main relay pin 30, and 4-ch relay module CH1 COM (power hold). | 7.5A, 16 AWG | Always live. Tier 3: CarPiHAT 12V battery input instead.
Red | +12V accessory (ignition) | 1) Diode D1 -> main relay coil pin 86. 2) Optocoupler CH1 input (ACC sense -> GPIO3). | 2A, 18 AWG | On a Ford the accessory feed drops during cranking. The Pi rides through on the relay hold. Tier 3: CarPiHAT ignition input.
Black (or chassis ground) | Ground | Main relay pin 85, both converters' GND, amp GND (amp to its own chassis point). | 16 AWG | Metra harnesses may not include a ground. Use a clean bolted chassis point and sand to bare metal.
Orange (Orange/White) | Dash illumination (+12V when lights on) | Optocoupler CH2 input -> GPIO4 (night mode / screen dimming). | 1A, 18 AWG | Optional but recommended.
Blue/White | Amp remote turn-on | 4-ch relay module CH2: COM = relay pin 87 (switched 12V), NO -> amp REM. | 1A, 18 AWG | The Pi turns the amp on after audio is up, so there's no turn-on pop.
Blue | Power antenna / antenna amp | 4-ch relay module CH3: COM = relay pin 87, NO -> blue wire. | 1A, 18 AWG | Raised only while the radio app is playing.
(none) | Main relay pin 87 (switched 12V) | -> 5V 5A converter (Pi), -> 5V 3A converter (screen + USB hub), -> TPA3116 boards (tiers 1-2). | 15A, 16 AWG | Tier 3 amps get their own fused feed from the battery.
(none) | Power hold | 4-ch relay CH1: COM = fused constant 12V, NO -> diode D2 -> relay coil pin 86. | - | Driven by GPIO26 through the gpio-poweroff overlay: the hold stays on until the Pi has fully halted.
White / White-Black | Left door speaker + / - | Amp L out | 18 AWG | NA Miata has 2 door speakers (no headrest speakers).
Gray / Gray-Black | Right door speaker + / - | Amp R out | 18 AWG
Green, Violet (+/-) | Rear speaker leads | Cap and tape, unused | - | Leave capped in case you add speakers later.
Pi GPIO3 (pin 5) | ACC sense (active low) + wake | Optocoupler CH1 output | - | Opto pulls it low when ACC is on. A low GPIO3 also wakes a halted Pi 4. Keep I2C off in tiers 1-2.
Pi GPIO4 (pin 7) | Dash-light sense (active low) | Optocoupler CH2 output | -
Pi GPIO26 (pin 37) | Power hold | 4-ch relay module IN1 | - | dtoverlay=gpio-poweroff,gpiopin=26,active_low=1
Pi GPIO27 (pin 13) | Amp remote | 4-ch relay module IN2 | -
Pi GPIO22 (pin 15) | Power antenna | 4-ch relay module IN3 | -
Pi GPIO23 (pin 16) | Spare (reverse camera / future) | 4-ch relay module IN4 | -
Pi 5V (pin 2) / GND (pin 6) | Relay and opto module logic power | Module VCC / GND | - | About 70 mA per energized relay.
