frozenframework/Pi4B_HeadUnit/cad/headunit_mount_assembly.step

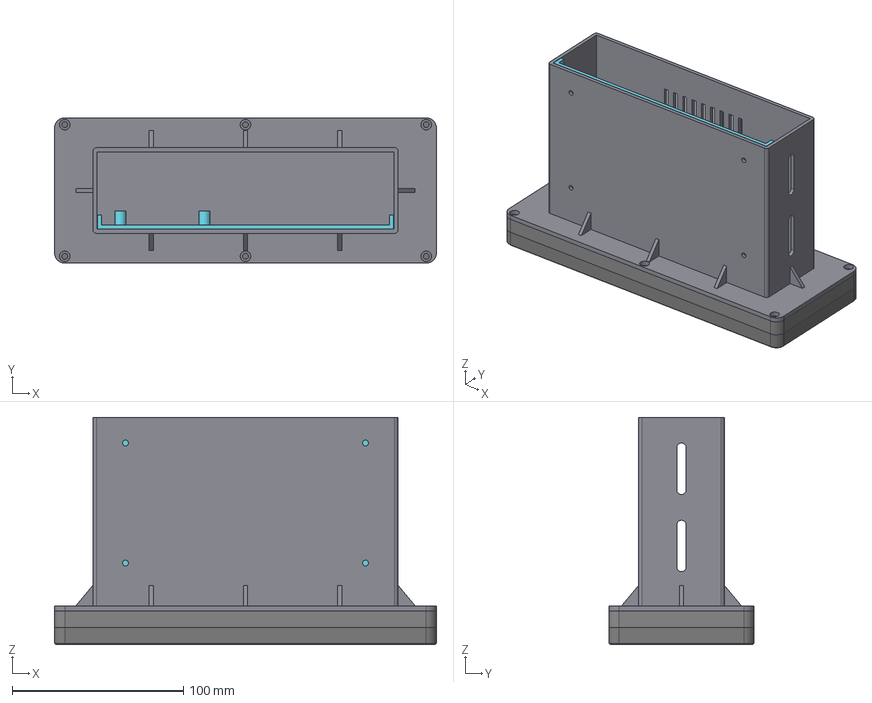
[picture p10: CAD file, 2026-10-30]
cad/headunit_mount_assembly.step
222.8 x 84.8 x 132.6 mm
bezel
spacer_ring
back_and_sled
pi_tray
