frozenframework/Pi4B_HeadUnit/cad/print/2din-pitouch2/headunit_mount_assembly.step

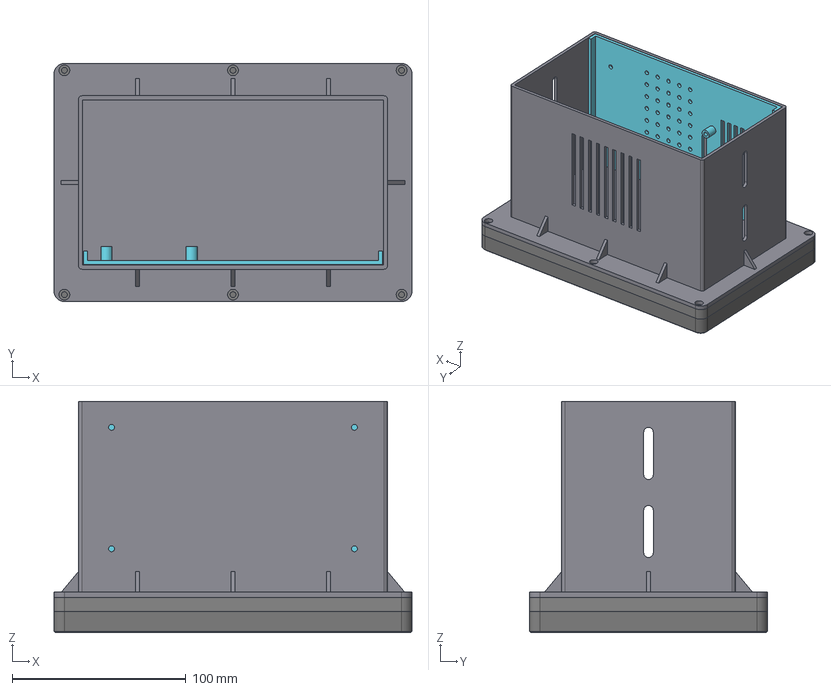
[picture p11: CAD file, 2026-10-31]
cad/print/2din-pitouch2/headunit_mount_assembly.step
206.3 x 137.2 x 133.3 mm
bezel
spacer_ring
back_and_sled
pi_tray
