frozenframework/Pi4B_HeadUnit/cad/print/2din-pitouch2/2_spacer_ring.step

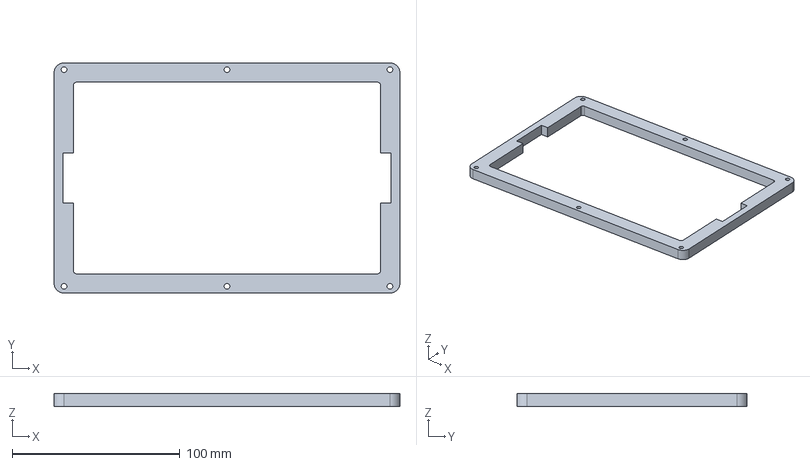
[picture p12: CAD file, 2026-10-31]
cad/print/2din-pitouch2/2_spacer_ring.step
206.3 x 137.2 x 8.00 mm
