frozenframework/Pi4B_HeadUnit/cad/4_pi_tray.step

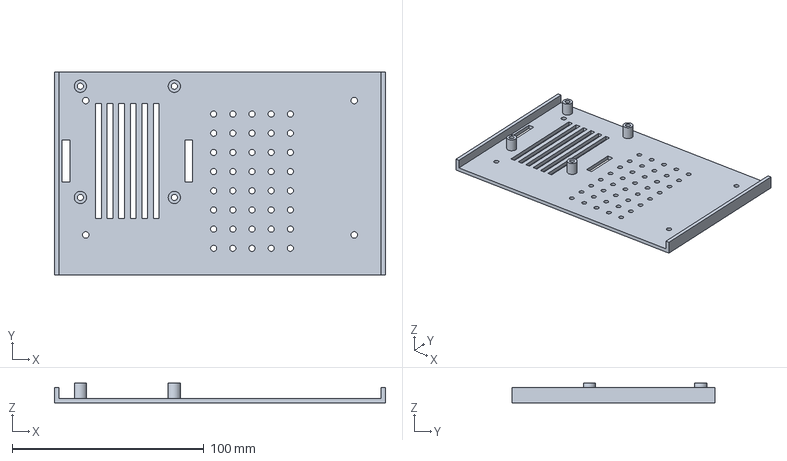
[picture p13: CAD file, 2026-10-30]
cad/4_pi_tray.step
172.6 x 106.0 x 10.4 mm
