frozenframework/Pi4B_HeadUnit/cad/print/2din-pitouch2/3_back_and_sled.step

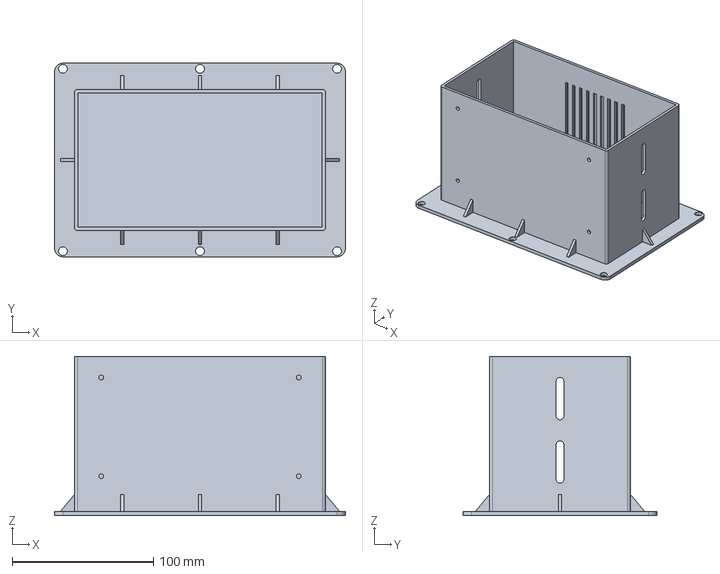
[picture p14: CAD file, 2026-10-31]
cad/print/2din-pitouch2/3_back_and_sled.step
206.3 x 137.2 x 113.0 mm
