frozenframework/Pi4B_HeadUnit/cad/2_spacer_ring.step

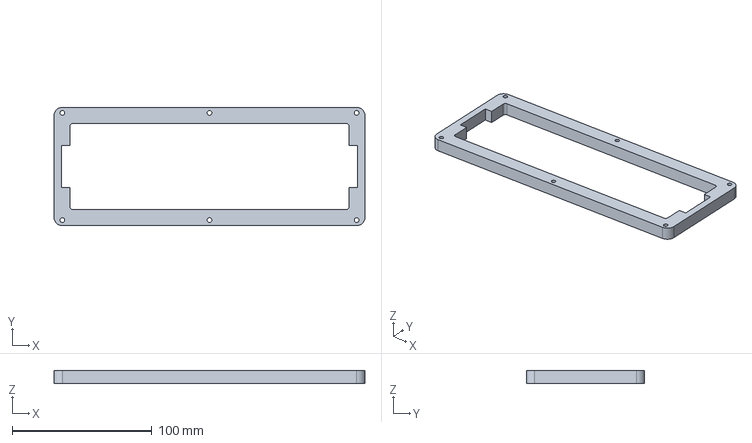
[picture p15: CAD file, 2026-10-30]
cad/2_spacer_ring.step
222.8 x 84.8 x 9.50 mm
