frozenframework/Pi4B_HeadUnit/cad/3_back_and_sled.step

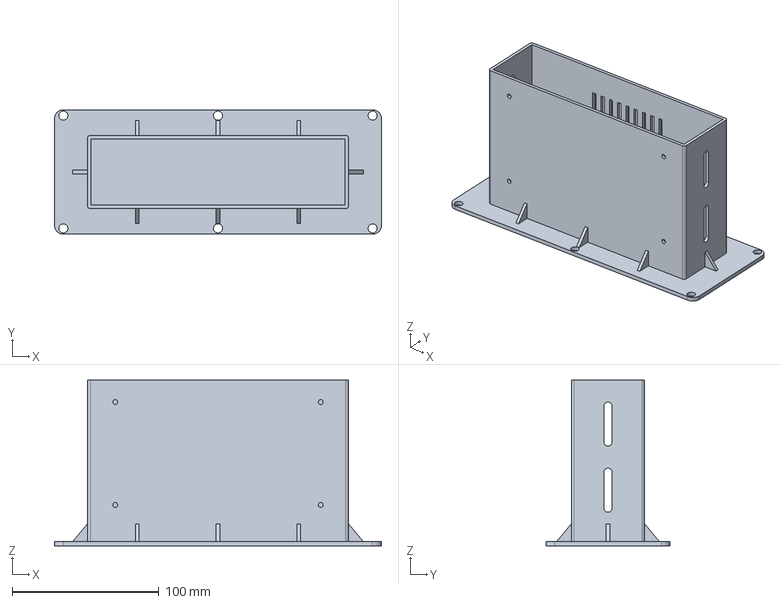
[picture p16: CAD file, 2026-10-30]
cad/3_back_and_sled.step
222.8 x 84.8 x 113.0 mm
