frozenframework/Pi4B_HeadUnit/cad/1_bezel.step

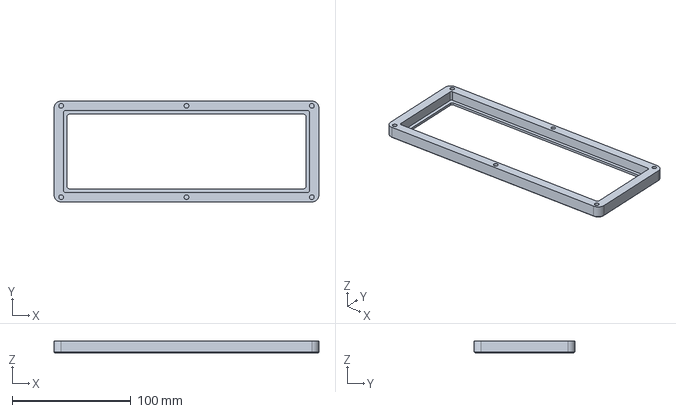
[picture p17: CAD file, 2026-10-30]
cad/1_bezel.step
222.8 x 84.8 x 10.1 mm
