frozenframework/Pi4B_HeadUnit/cad/print/2din-pitouch2/1_bezel.step

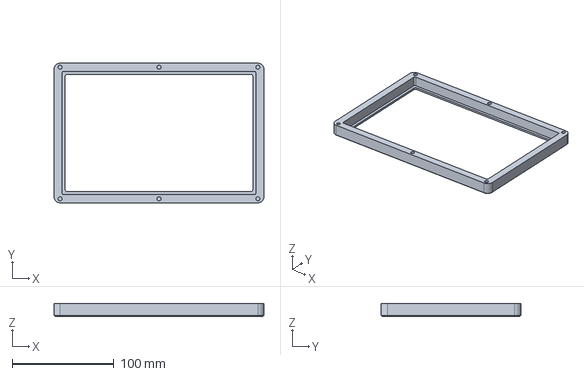
[picture p18: CAD file, 2026-10-31]
cad/print/2din-pitouch2/1_bezel.step
206.3 x 137.2 x 12.3 mm
