frozenframework/Pi4B_HeadUnit/cad/print/2din-7in/headunit_mount_assembly.step

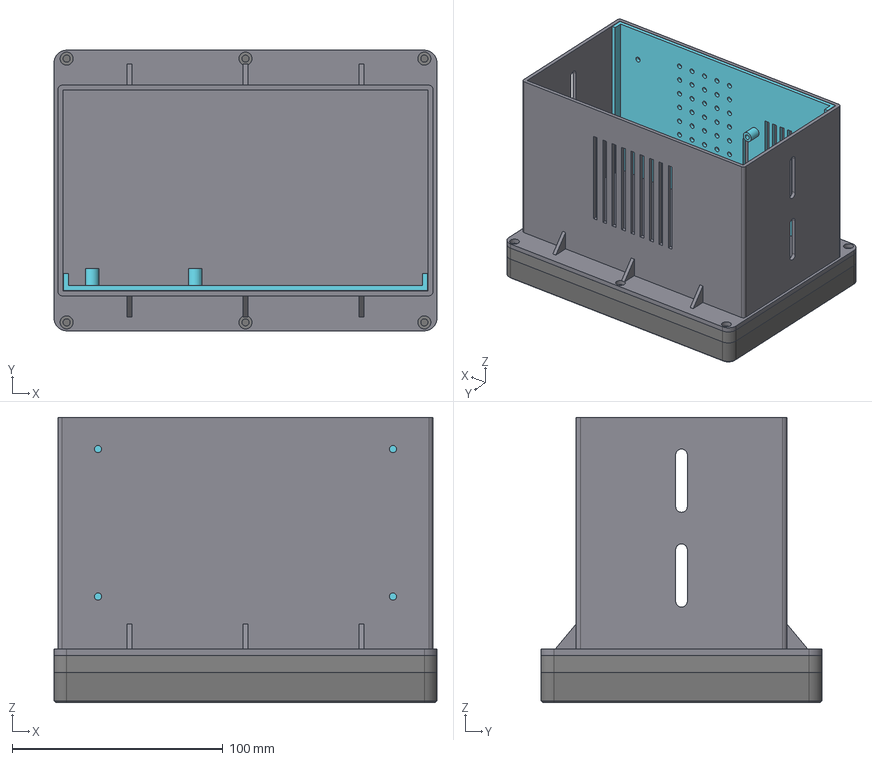
[picture p19: CAD file, 2026-10-31, an earlier design]
cad/print/2din-7in/headunit_mount_assembly.step
181.8 x 133.2 x 135.3 mm
bezel
spacer_ring
back_and_sled
pi_tray
