frozenframework/Pi4B_HeadUnit/cad/print/2din-7in/2_spacer_ring.step

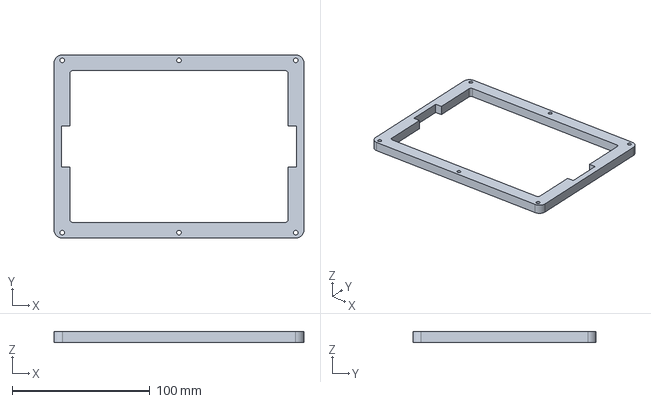
[picture p20: CAD file, 2026-10-31, an earlier design]
cad/print/2din-7in/2_spacer_ring.step
181.8 x 133.2 x 8.00 mm
