frozenframework/Pi4B_HeadUnit/cad/print/2din-7in/1_bezel.step

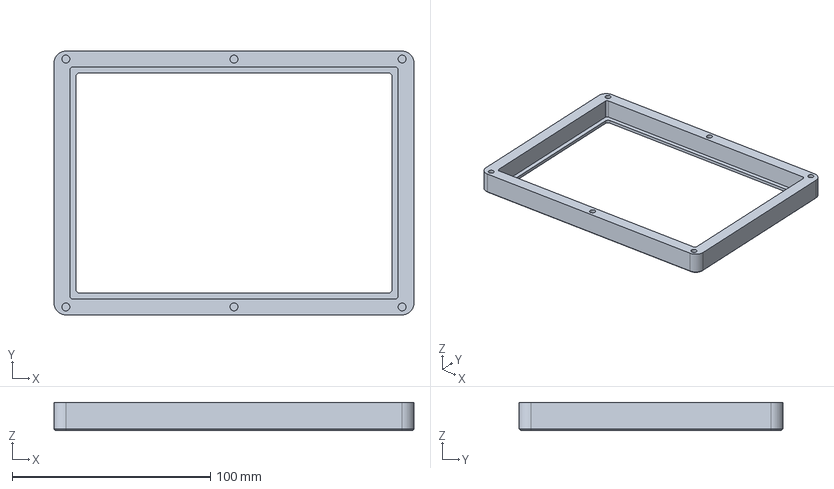
[picture p21: CAD file, 2026-10-31, an earlier design]
cad/print/2din-7in/1_bezel.step
181.8 x 133.2 x 14.3 mm
