frozenframework/Pi4B_HeadUnit/cad/print/2din-7in/3_back_and_sled.step

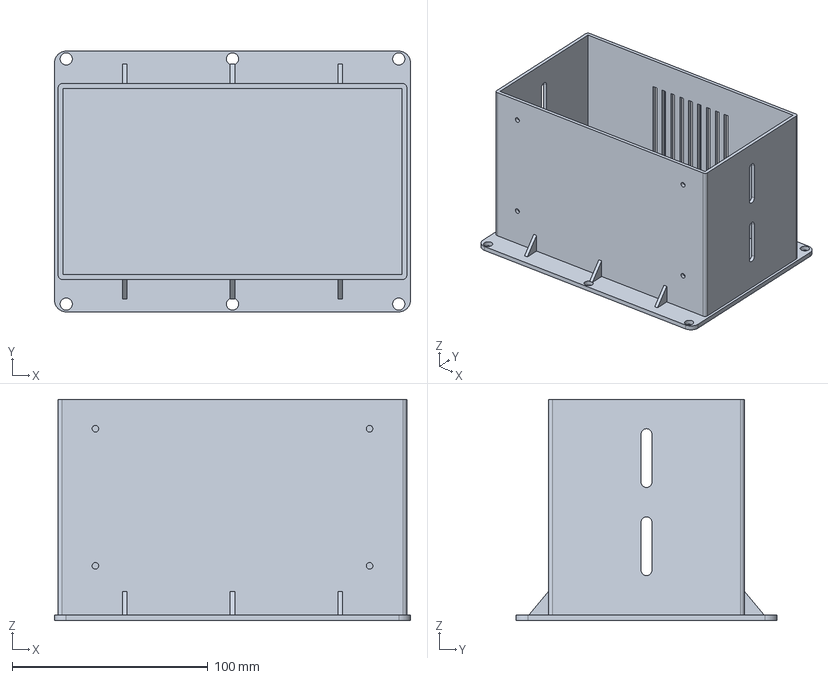
[picture p22: CAD file, 2026-10-31, an earlier design]
cad/print/2din-7in/3_back_and_sled.step
181.8 x 133.2 x 113.0 mm
