frozenframework/Pi4B_HeadUnit/(list of files, cad)

Other CAD files:
cad/print/2din-pitouch2/4_pi_tray.step
cad/print/1din-waveshare79/headunit_mount_assembly.step
cad/print/1din-waveshare79/2_spacer_ring.step
cad/print/1din-waveshare79/3_back_and_sled.step
cad/print/1din-waveshare79/4_pi_tray.step
cad/print/1din-waveshare79/1_bezel.step
cad/print/1din-waveshare79/1_bezel.stl
cad/print/1din-waveshare79/2_spacer_ring.stl
cad/print/1din-waveshare79/3_back_and_sled.stl
cad/print/2din-7in/1_bezel.stl
cad/print/2din-7in/2_spacer_ring.stl
cad/print/2din-7in/3_back_and_sled.stl
cad/print/2din-7in/4_pi_tray.step
cad/print/2din-pitouch2/1_bezel.stl
cad/print/2din-pitouch2/2_spacer_ring.stl
cad/print/2din-pitouch2/3_back_and_sled.stl
cad/print/2din-pitouch2/4_pi_tray.stl
