frozenframework/Pi4B_HeadUnit/tools/tests/test_hudiy_theme.py

"""Hudiy skin sync: the config gets dark/light, source color, color roles and background in both theme
sections plus CarPlay/Android Auto day-night = common; --live sends SetDarkMode (37) and SetThemeColors (54);
syncHudiyColors=false turns it off; unrelated keys survive; day and night skins go in Hudiy's light and dark
sections, so sunrise / sunset only flips dark mode."""
import json, os, socket, struct, subprocess, sys, tempfile, threading
from pathlib import Path
ROOT = Path(__file__).resolve().parents[2]
T = Path(tempfile.mkdtemp()); home = T / "home"; cfgdir = home / ".hudiy/share/config"; cfgdir.mkdir(parents=True)
cfg = cfgdir / "main_configuration.json"
base = {"theme": {"darkThemeEnabled": False, "availableColors": ["#ff0000"],
                  "dark": {"sourceColor": "#123456", "contrastLevel": 0.0, "colorOverwrite": {"surfaceTint": "#010101"}},
                  "light": {"sourceColor": "#654321", "contrastLevel": 0.0}},
        "androidAuto": {"dayNightMode": "day", "dpi": 140}, "autobox": {"dayNightMode": "NIGHT", "productId": 5409},
        "api": {"tcpEndpointPort": 0}, "appearance": {"showClock": True}}

# strict fake Hudiy API (only listens after its hello response, like the real one)
sys.path.insert(0, str(Path(__file__).resolve().parent))
from fake_hudiy import FakeHudiy
hud = FakeHudiy(); port = hud.port; got = hud.got
base["api"]["tcpEndpointPort"] = port
cfg.write_text(json.dumps(base))

env = {**os.environ, "HOME": str(home), "HU_STYLES": str(ROOT / "apps/styles"), "HU_HUDIY_BG": str(T / "bg"), "HU_CONF": str(T / "none")}
run = lambda *a: subprocess.run([sys.executable, str(ROOT / "bin/hu-hudiy-theme.py"), *a], env=env, capture_output=True, text=True)
r = run("neon-overdrive", "--live"); print(r.stdout.strip())
d = json.loads(cfg.read_text())
assert d["theme"]["darkThemeEnabled"] is True
for sec in ("dark", "light"):
    s = d["theme"][sec]
    assert s["sourceColor"] == "#00E5FF" and s["colorOverwrite"]["primary"] == "#00f0ff" and s["colorOverwrite"]["surface"] == "#07060d"
    co = s["colorOverwrite"]                     # notifications / toasts follow the skin too
    assert co["inverseSurface"] == co["surfaceContainer"] and co["inverseOnSurface"] == co["onSurface"] and co["inversePrimary"] == co["primary"], co
    assert {"primaryContainer", "onPrimaryContainer", "secondaryContainer", "onSecondaryContainer"} <= set(co)
    assert s["defaultBackground"].endswith("neon-overdrive.jpg") and Path(s["defaultBackground"]).exists()
assert d["theme"]["dark"]["colorOverwrite"]["surfaceTint"] == "#010101", "existing overwrite kept"
assert d["androidAuto"]["dayNightMode"] == "common" and d["autobox"]["dayNightMode"] == "COMMON"   # keeps Hudiy's spelling
assert d["androidAuto"]["dpi"] == 140 and d["autobox"]["productId"] == 5409 and d["appearance"]["showClock"] is True
assert (cfgdir / "main_configuration.json.hu-orig").exists()
import time; time.sleep(0.6)
ids = [m for m, _ in got]
assert hud.hellos and not hud.early, ("sent before Hudiy's hello response", hud.early)
assert ids[:2] == [37, 54] and ids[-1] == 49, ids
assert got[0][1] == b"\x08\x01", got[0]                       # SetDarkMode enabled=true
assert b"#00E5FF" in got[1][1], got[1]
# light skin, at startup, from settings.json
(home / ".config/headunit").mkdir(parents=True); (home / ".config/headunit/settings.json").write_text(json.dumps({"theme": "sunset-junction"}))
print(run("--startup").stdout.strip())
d = json.loads(cfg.read_text()); assert d["theme"]["darkThemeEnabled"] is False and d["theme"]["light"]["sourceColor"] == "#FF6A1A"
# day and night skins: Hudiy's light section = the day skin, dark section = the night skin, dark mode at night,
# so the bridge only flips dark mode at sunrise / sunset and everything in Hudiy changes with it
(home / ".config/headunit/settings.json").write_text(json.dumps({"theme": "after-midnight", "dayNight": True,
                                                                  "dayTheme": "sunset-junction", "nightTheme": "after-midnight"}))
n0 = len(got); print(run("after-midnight", "--live").stdout.strip()); time.sleep(0.6)
d = json.loads(cfg.read_text())["theme"]
assert d["darkThemeEnabled"] is True and d["dark"]["sourceColor"] == "#39FF88" and d["light"]["sourceColor"] == "#FF6A1A", d
assert d["light"]["defaultBackground"].endswith("sunset-junction.jpg") and d["dark"]["defaultBackground"].endswith("after-midnight.jpg")
live = [(m, p) for m, p in got[n0:] if m in (37, 54)]
assert live[0] == (37, b"\x08\x01") and b"#39FF88" in live[1][1] and b"#FF6A1A" in live[1][1], live
n0 = len(got); run("sunset-junction", "--live"); time.sleep(0.6)
assert json.loads(cfg.read_text())["theme"]["darkThemeEnabled"] is False
assert [(m, p) for m, p in got[n0:] if m == 37] == [(37, b"\x08\x00")], "sunrise: dark mode off"
# switched off in Settings
(home / ".config/headunit/settings.json").write_text(json.dumps({"theme": "street-heat", "syncHudiyColors": False}))
print(run("--startup").stdout.strip())
assert json.loads(cfg.read_text())["theme"]["light"]["sourceColor"] == "#FF6A1A", "unchanged when off"
print("hudiy theme: all tests passed")
