frozenframework/Pi4B_HeadUnit/tools/tests/test_hudiy_start.py

"""Start screen: hu-hudiy-start.py sets Hudiy's defaultAction to the map (or back to Hudiy's dashboard)
and, once Hudiy's API answers, dispatches the map action exactly once."""
import json, os, socket, struct, subprocess, sys, tempfile, threading, time
from pathlib import Path
ROOT = Path(__file__).resolve().parents[2]
H = Path(tempfile.mkdtemp()); cfg = H / ".hudiy/share/config/main_configuration.json"; cfg.parent.mkdir(parents=True)
st = H / ".config/headunit/settings.json"; st.parent.mkdir(parents=True)
s = socket.socket(); s.bind(("127.0.0.1", 0)); port = s.getsockname()[1]; s.close()
cfg.write_text(json.dumps({"application": {"defaultAction": "", "showMenuIcon": True}, "api": {"tcpEndpointPort": port}}))
env = {**os.environ, "HOME": str(H)}
def run(*a): return subprocess.run([sys.executable, str(ROOT / "bin/hu-hudiy-start.py"), *a], env=env, capture_output=True, text=True, timeout=30)

r = run("--config"); app = json.loads(cfg.read_text())["application"]
assert app["defaultAction"] == "hu_navigation" and app["showMenuIcon"] is True, (app, r.stderr)
st.write_text(json.dumps({"startOnMap": False})); run("--config")
assert json.loads(cfg.read_text())["application"]["defaultAction"] == "", "switch off should give Hudiy's dashboard"
print("1) defaultAction follows the Start on the map switch (default on)")

got = []
sys.path.insert(0, str(Path(__file__).resolve().parent))
from fake_hudiy import FakeHudiy
hud = {}
def fake_hudiy():                       # Hudiy's API comes up a few seconds after the head unit starts
    time.sleep(3); hud["h"] = FakeHudiy(port=port, listen_for=12)
threading.Thread(target=fake_hudiy, daemon=True).start()
st.write_text(json.dumps({"startOnMap": True}))
r = run("--open"); time.sleep(0.5)
assert "sent" in r.stdout, (r.stdout, r.stderr)
h = hud["h"]; got = h.got; ids = h.ids()
assert h.hellos and not h.early, ("sent before Hudiy's hello response", h.early)
assert 43 in ids, got                              # DispatchAction after Hudiy's hello response
payload = dict(got)[43]; assert b"hu_navigation" in payload, payload
assert 1 <= ids.count(43) <= 2
print("2) waits for Hudiy's API, then opens the map once:", ids)
st.write_text(json.dumps({"startOnMap": False})); n = len(h.got)
r = run("--open"); assert "open map" not in r.stdout and len(h.got) == n
print("3) switch off: nothing dispatched")
print("hudiy start screen: all tests passed")
