frozenframework/Pi4B_HeadUnit/(commit log)

2026-10-30 Initial commit: Pi4B Headunit
    Raspberry Pi 4B head unit for a 1997 Ford F-250 7.3L and a 1997 Mazda Miata:
    Hudiy (CarPlay via Carlinkit, Android Auto), themed offline navigation
    (MapLibre + Protomaps + Valhalla), iPod/USB music via MPD, AM/FM via
    RTL-SDR, ignition-safe power management, setup script, image builder,
    3D-printable mount (STEP/STL) and parts lists.
    Claude-Session: https://claude.ai/code/session_01A1sBC74m8sQ5b4s1cDGRWA
    [1_bezel.step, 1_bezel.stl, 2_spacer_ring.step, 2_spacer_ring.stl, 3_back_and_sled.step, 3_back_and_sled.stl, 4_pi_tray.step, 4_pi_tray.stl]
2026-10-30 Add no-Docker image builder (image/make-image.py)
    Builds ready-to-flash F-250 and Miata images from the official
    Raspberry Pi OS (64-bit, Desktop) image without Docker or root:
    only the FAT boot partition is edited. The project is copied to
    bootfs/headunit/package and a one-time systemd.run hook in
    cmdline.txt installs it to /opt/headunit on first power-up, enables
    headunit-firstboot.service, removes itself and reboots.
    - steps can run separately (patch_boot / compress) and --no-compress
    - FAT writes delete-then-recreate to avoid a pyfatfs overwrite bug
    - README: documents the no-Docker path
    Claude-Session: https://claude.ai/code/sess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
2026-10-31 Add 2017 Nissan Frontier: double-DIN + factory backup camera
    - config/frontier.conf profile (20 s key-off delay, 4 speakers, camera on)
    - 20-display: DISPLAY_TYPE (waveshare-7.9, hdmi-1024x600, pi-touch-display-2)
    - 75-camera: USB composite capture -> /dev/hu-rearcam (NTSC); Hudiy
    reverseCamera pipeline set by hu-hudiy-config.py
    - hu-power: reverse input shows/hides the camera via Hudiy's local API
    (bin/hu_hudiy_api.py, hand-encoded protobuf; tested against a mock)
    - apps: layouts adapt to 1024x600 / 1280x720
    - cad: profiles; 2din-7in set for a 7in screen over a double-DIN opening
    - docs/Frontier_2DIN_Parts_List.xlsx; image builders accept frontier/all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
    [1_bezel.step, 1_bezel.stl, 2_spacer_ring.step, 2_spacer_ring.stl, 3_back_and_sled.step, 3_back_and_sled.stl, 4_pi_tray.step, 4_pi_tray.stl]
2026-10-31 Frontier SV: steering-wheel controls + parts list for the final spec
    - bin/hu-swc.py: resistor-ladder wheel buttons via MCP3008 (SPI).
    --raw shows live values, --learn records your buttons to
    /etc/headunit/swc.json; the service debounces, repeats volume while
    held and dispatches Hudiy actions (overridable per button)
    - setup.d/77-swc.sh + headunit-swc.service (SWC=1 in frontier.conf)
    - tools/tests/test_swc.py: simulated ladder covers learn, debounce, repeat
    - Frontier parts list: SV dash kit (99-7581), base audio (no sub),
    factory camera, 900-nit screen, SWC parts; Pi already owned
    - README: SWC wiring, learn steps
    Claude-Sessi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
    [Frontier_2DIN_Parts_List.xlsx]
2026-10-31 Frontier: three budget tiers ($100/$250/$500)
    - docs/Frontier_2DIN_Parts_List.xlsx: Summary + tier columns. Tier 1
    essentials with Pi Touch Display 2; tier 2 adds CarPlay, factory
    camera, GPS; tier 3 = chosen spec (900-nit screen, wheel controls)
    - config/tiers.conf: per-vehicle tier overrides (FRONTIER_TIERn);
    setup.sh uses them when present. Frontier never switches to CarPiHAT
    - cad: 2din-pitouch2 profile for the Touch Display 2
    Claude-Session: https://claude.ai/code/session_01A1sBC74m8sQ5b4s1cdGRWA
    [1_bezel.step, 1_bezel.stl, 2_spacer_ring.step, 2_spacer_ring.stl, 3_back_and_sled.step, 3_back_and_sled.stl, 4_pi_tray.step, 4_pi_tray.stl]
2026-11-03 Software screen dimmer for every screen, in Settings > Display
    - bin/hu-dimmer.py: picks the best method per screen: backlight
    (Touch Display 2), DDC/CI over HDMI (ddcutil), or a click-through
    GTK layer-shell overlay above everything (Waveshare 7.9"). Manual
    level, or auto-dim with day/night levels from the dash-light wire.
    Floors: 5% backlight, 20% overlay
    - systemd/headunit-dimmer.service (user session, waits for Wayland)
    - setup.d/45-dimmer.sh: packages, backlight udev permissions, i2c-dev
    - bridge: nested display settings + /api/display/status
    - Settings app: Display page with large touch sliders
    - tests: test_dimmer.py (backlight/DDC with fake hardware); overlay
    verified on he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
2026-11-03 Signed over-the-air software updates (v1.1.0)
    - bin/hu-update.py: checks GitHub for tags vX.Y.Z newer than the running
    version every 30 min and whenever Wi-Fi connects. A tag is accepted only
    if it is signed by a key in config/release-signers (SSH signature, git
    verify-tag), its name matches the tag object, and VERSION agrees.
    Unsigned, other-key, lightweight and renamed tags are refused and never
    retried. It downloads ~4 MB (docs/ and cad/print/ are left out) plus any
    new Debian packages for an offline install later.
    - Installs at the next key-on, before the screen starts: each version
    lives in /opt/headunit-releases/X.Y.Z and /opt/headunit is a symlink
    swapped atomically, a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
    [hu-bridge.py, hu-hudiy-config.py, hu-update.py, test_update.py]
2026-11-03 Bench testing on any HDMI monitor: DISPLAY_TYPE=monitor
    - 20-display: new "monitor" type uses the monitor's own native resolution,
    no forced timings, no rotation (MONITOR_ROTATE, default 0), and touch
    mapped to HDMI-A-1 (so USB touch monitors like ELO work too).
    - Fixed: kanshi needs "normal", not "0", for an unrotated screen. This
    affected the Frontier tier 3 1024x600 screen too.
    - setup.sh --set KEY=VALUE changes one setting in headunit.conf, e.g.
    sudo /opt/headunit/setup.sh --set DISPLAY_TYPE=waveshare-7.9 --only 20-display
    - First boot takes DISPLAY_TYPE / DISPLAY_ROTATE / POWER_MODE from the
    card's headunit.conf, so the bench screen can be picked before flashing.
    Co-Authored-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
2026-11-03 No setup wizard; default user + US region; 10 languages; Developer menu (v1.2.0)
    First power-up (image/make-image.py firstrun.sh) now does what Raspberry Pi's
    on-screen wizard used to ask, so the wizard never appears:
    - creates user "headunit" / password "headunit" (HU_USERNAME/HU_PASSWORD in
    the card's headunit.conf; the password is erased from the card after use),
    with sudo and desktop autologin, through Raspberry Pi's own cancel-rename
    - country US, en_US.UTF-8, America/Chicago, US keyboard (WIFI_COUNTRY,
    LOCALE, TIMEZONE, KEYBOARD), hostname <vehicle>-headunit, ENABLE_SSH=0
    - cloud-init is disabled unless Imager's customisation was used instead
    - make-image.py --set KEY=VALUE prese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
2026-11-03 Language switch: use the locale names Raspberry Pi OS lists (vi_VN, hi_IN have no .UTF-8 suffix)
    Checked against /usr/share/i18n/SUPPORTED in the 2026-10-06 Raspberry Pi OS image: all 10 languages are available.
    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
2026-11-03 First boot installs Hudiy unattended from its real installer package
    Hudiy's hudiy_installer.tar.gz runs hudiy_installer/run.sh, which asks for
    the order number (checked online: Hudiy's license check) and then "reboot
    now? [y/n]". First boot now finds that run.sh (the old *install*.sh search
    missed it), answers the order number from HUDIY_ORDER in the card's
    headunit.conf and "n" to the reboot, and runs it as the head-unit user
    with a 60-minute limit. After a successful install it deletes the
    installer and the order number from the card. Without HUDIY_ORDER it
    leaves a copy in ~/hudiy_installer to run from the Developer terminal.
    The bridge also switches Hudiy's own Wi-Fi hotspot back off a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
    [hu-bridge.py]
2026-11-03 Tier 3: real CarPiHAT pin map, its clock, and whole-US maps
    TIER3 (F-250 and Miata) now sets the TJD CarPiHAT's own pins from its
    Quick Start Guide instead of the DIY relay-board ones: ignition sense
    GPIO12 (active high), latch GPIO25 (gpio-poweroff, active low),
    illumination GPIO13 (active high), OUT_0 GPIO27 amp remote, OUT_1 GPIO22
    power antenna. hu-power.py reads ACC_ACTIVE / ILLUM_ACTIVE /
    REVERSE_ACTIVE (low for the DIY optocouplers, high for the CarPiHAT).
    30-power keeps I2C on in CarPiHAT mode and adds the i2c-rtc overlay for
    its clock (RTC=ds1307 default, ds3231 for v0.3 boards, none), and drops
    fake-hwclock. Tier 3's 256GB card gets MAP_REGION=us.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
    [hu-power.py]
2026-11-03 Fixes from the first real Miata boot (blank screen, maps, clock, log)
    From bootfs/headunit/firstboot.log of the first tier-3 install:
    - Map download failed with KeyError 'texas-plus\nus\nus': headunit.conf
    listed MAP_REGION three times (vehicle, tier, --region) and the updater
    read them all. setup.sh now writes each key once (the last value wins)
    and hu-update-maps.sh takes the last line.
    - The Pi booted with the image's date (no clock yet), so apt rejected the
    package signatures as "not live until" today. First boot now waits for
    network time, falling back to a web server's Date header.
    - Hudiy's installer echoes the order number into the log on the card.
    It's now replaced with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
    [hu-dimmer.py]
2026-11-03 First boot: maps download in the background; visible setup progress
    From the second Miata install log: Hudiy and setup finished, then first
    boot sat on the whole-US map download (15 GB) with only the plain desktop
    on screen. The Pi was restarted ~22 min in, so first boot started over
    and Hudiy never came up.
    - Setup no longer waits for maps: MAPS_AUTO=1 now marks a download that
    headunit-maps-firstrun.service runs in the background after the
    reboot (and again on later boots until it completes). Settings > Maps
    shows progress.
    - While setup runs, a terminal window on the desktop shows its log and
    says to leave the Pi powered on (bin/hu-setup-progress.sh, desktop
    autostart; it exits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
2026-11-03 Fix the desktop never starting after setup (autologin pointed at "pi")
    diag.txt from the third Miata install: lightdm looped "Failed to start
    session, starting greeter" and no desktop session ever started, so Hudiy
    (a user service in that session) never ran.
    Cause: Raspberry Pi OS Trixie ships a placeholder account "pi" (uid
    1000, /usr/sbin/nologin, locked) that its setup wizard renames.
    firstrun.sh made "headunit" as a second account (uid 1001). Then
    20-display ran "raspi-config nonint do_boot_behaviour B4" from the
    first-boot service, with no SUDO_USER, so raspi-config fell back to the
    uid-1000 account and set autologin-user=pi, which can't log in.
    - firstrun.sh now renames the placehold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
2026-11-03 Your own boot picture instead of the Raspberry Pi logo
    - setup.d/25-bootsplash.sh: if a boot-splash.png is supplied (the card's
    bootfs/headunit/, or /etc/headunit/), install a Plymouth theme
    "headunit" that shows it centered and scaled on black, make it the
    default (rebuilds the initramfs), and turn off the firmware's rainbow
    screen (disable_splash=1). With no picture the boot screen is left alone.
    - make-image.py --splash FILE puts the picture on the card only. The
    picture is personal: private/ and boot-splash*.png are git-ignored, and
    make-image.py never packages hudiy/ or private/.
    - python3-pil + plymouth added to the package list.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
2026-11-03 Hudiy menu apps: wait for the bridge with an image load, not fetch()
    Opening Head Unit Settings from Hudiy's Drive menu showed "Head-unit
    service not responding". The loader page Hudiy opens is a local file
    (file:///opt/headunit/apps/loader.html) and checked the bridge with
    fetch('http://127.0.0.1:8765/...'). Hudiy's web view is QtWebEngine, whose
    default LocalContentCanAccessRemoteUrls=false stops local pages from making
    fetch/XHR calls to http:// addresses, so the check never succeeded even
    with the bridge running. (The bridge itself starts and answers in a Debian
    Trixie test with the same packages.)
    The loader now probes with an image (apps/common/ping.png), which local
    pages may load, t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
2026-11-04 Hudiy (and CarPlay / Android Auto day-night) follow the map skin
    Uses the appearance keys from Hudiy's main_configuration.md and the API
    messages from its api/Api.proto:
    - bin/hu-hudiy-theme.py writes theme.darkThemeEnabled, and in every
    theme section with a sourceColor: the skin's accent as sourceColor,
    Material 3 colorOverwrite roles from the skin's palette, and a
    defaultBackground picture; androidAuto/autobox dayNightMode = "common"
    so CarPlay and Android Auto use their night look with dark skins. A
    one-time backup is kept (*.hu-orig). --live also recolors the running
    Hudiy with SetDarkMode (37) and SetThemeColors (54), no restart.
    - Applied before Hudiy starts (first line of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
2026-11-04 Hudiy opens the head-unit apps straight from the bridge (http://)
    On the Miata the bridge was running (systemctl status: active) but the
    Drive menu apps still said "Head-unit service not responding": Hudiy's
    web view doesn't let the local file:// loader page check the bridge, by
    fetch() or by image. Hudiy's own web widgets use http://127.0.0.1:<port>
    addresses, so the apps now do too:
    - hu-hudiy-config.py registers http://127.0.0.1:<BRIDGE_PORT>/apps/<app>/
    instead of file:///opt/headunit/apps/loader.html?to=<app>.
    - bin/hu-wait-bridge.sh runs in the desktop autostart just before Hudiy
    and waits up to 30 s for the bridge, so the apps load on the first try
    (Hudiy shows an error if a web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
    [hu-hudiy-config.py]
2026-11-04 Map updater: no start timeout, 3 tries, says which step failed; diag shows map + network state
    - headunit-update-maps.service: TimeoutStartSec=infinity (the whole-US download is ~15 GB).
    - hu-update-maps.sh retries the download up to 3 times (a Wi-Fi drop ends it; it can't resume) and the
    failure message in Settings > Maps now names the step that failed.
    - diag.txt: map update status + log, free space, network devices, and whether build.protomaps.com answers.
    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
2026-11-04 Map download resumes instead of starting over
    pmtiles extract gives up on the first dropped stream (e.g. HTTP/2 INTERNAL_ERROR at 87% of the
    whole-US map) and can't resume. It now reads through bin/hu-range-proxy.py, a local proxy that
    saves every byte range to /var/lib/headunit/maps/download-cache/<build>, retries and continues
    broken ranges from the last byte, and serves saved ranges from disk. A failed run keeps the
    cache, so the next run (Settings > Maps or the service) continues where it stopped; the same
    build is reused while the server still has it. 5 tries per run, space check counts the cache.
    Claude-Session: https://claude.ai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
    [hu-range-proxy.py, test_range_proxy.py]
2026-11-04 Settings > Maps: download progress bar with percent and time left
    hu-update-maps.sh pipes the extractor through bin/hu-maps-progress.py, which reads its progress
    bar plus the range proxy's byte counters (new --stats) and writes percent, size, internet speed
    (3-minute average) and time left to update-status.json every 2 s, with a phase
    (preparing/downloading/retrying/checking/done/failed). The bridge adds whether the updater is
    still running, so a download cut off by a reboot shows 'Stopped at NN%' instead of looking stuck.
    The Maps page polls every 2 s and shows the bar, percent, time left and 'x GB of y GB · speed'
    in all 10 languages; the Update button is disabled while a download runs.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
    [hu-bridge.py, hu-maps-progress.py, hu-range-proxy.py, test_maps_progress.py]
2026-11-05 Push routing + search over Wi-Fi; Hudiy starts on the offline map
    tools/push-maps.py sends a HEADUNIT_MAPS folder to a head unit over ssh (macOS, Linux, Windows):
    progress with time left, continues from the last byte after a Wi-Fi drop or on a later run, skips
    files already sent, then runs hu-import-maps.sh, which now also accepts the Wi-Fi inbox
    /var/lib/headunit/incoming/HEADUNIT_MAPS and moves (not copies) files from it. --setup-key installs
    the computer's ssh key so there are no password prompts.
    bin/hu-hudiy-start.py sets Hudiy's application.defaultAction to the Navigation app before Hudiy
    starts and dispatches it once Hudiy's API answers, so the map is the first screen and the home
    bu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
    [hu-bridge.py, hu-hudiy-start.py, test_hudiy_start.py, test_push_maps.py]
2026-11-05 Phone on the offline map: stay on the map when CarPlay connects, show the phone's next turn
    bin/hu_phone.py (in the bridge) subscribes to Hudiy's status messages (projection, media,
    navigation, phone, current menu action) and:
    - keeps the offline map in front when a phone connects (Settings > Driving > When a phone
    connects: Stay on the map / Show CarPlay). Only the switch that comes with connecting is undone;
    CarPlay opened with the map's phone button or Hudiy's own buttons, or brought up by a call, stays.
    - shows the phone's next turn on the map (text, Hudiy's arrow picture or our own arrow from the
    maneuver type, distance) while Apple Maps / Google Maps / Waze guides on the phone
    -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
2026-11-05 Day and night map skins, switching at sunrise and sunset
    Settings > Map skin > Day and night skins: pick a day skin and a night skin. bin/hu_sun.py works
    out the sun's position, sunrise and sunset (NOAA equations, within 2 min of published times) from
    the GPS position (else the last known one, else the map region's middle) and the Pi's clock, so no
    internet is needed. The bridge checks every 30 s and switches the skin (and Hudiy's colors and dark
    mode, so CarPlay / Android Auto day-night follows) at sunrise and sunset; open screens follow.
    A skin picked while it's on becomes the skin for the current part of the day. /api/sun.
    Claude-Se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
2026-11-05 Settings from the map: Back to map button (no more getting stuck)
    The map's More settings link replaced the map page with Settings, which had no way back (and lost
    any route). Settings now opens in a layer over the map, which keeps running with its route, and
    Settings has a Back to map button at the top of its menu that closes the layer; the map then picks
    up changed skin, units and language. Opened from Hudiy's menu, the same button asks Hudiy for its
    home screen (the map with Start on the map on; 'Exit' to Hudiy's dashboard otherwise), via the new
    /api/hudiy/action (go_home / go_back / hu_navigation only).
    Claude-Session: https://cla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
    [hu-bridge.py]
2026-11-05 Release 1.2.6
    Back to map button in Settings
2026-11-05 Map screen: Map, iPod & USB, AM/FM Radio, Head Unit Settings buttons; radio screen fix
    A rail on the left of the map screen opens iPod & USB, AM/FM Radio and Head Unit Settings in a
    layer over the map (the map and any route keep running underneath; music and radio stay loaded and
    keep playing when you go back), and Map returns to the map. Settings' Back to map also closes it.
    Works on the 1024x600 and 1280x400 screens; skin previews render without the rail. The map's skin
    button gets a palette icon (the gear is Settings).
    Fix: the AM/FM Radio screen stopped part way through drawing since the 10-language update (a
    variable named t hid the translation function in the preset buttons), so prese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
2026-11-05 Release 1.2.7
    Map screen app buttons; radio screen fix
2026-11-05 Map screen buttons: Map, Music, Radio, Settings; Music shows what CarPlay is playing
    - The map screen's buttons are labeled Map, Music, Radio and Settings (all 10 languages).
    - Music: when a phone plays through CarPlay / Android Auto, the player shows it (cover art,
    title, artist, album, position) with previous / play-pause / next going to the phone, and an
    Open CarPlay button. Tabs switch between iPod & USB and CarPlay; on its own it shows the phone
    while the phone plays and the iPod / USB doesn't.
    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
2026-11-05 Release 1.2.8
    Map/Music/Radio/Settings buttons; CarPlay music in Music
2026-11-05 Go back to an earlier version; screens always match the installed version
    - Settings > Updates > Go back to X.Y.Z (versions still kept on the head unit): switches back, re-runs
    that version's setup, drops a waiting update, never reinstalls the version you left (newer ones
    still install) and restarts. hu-update.py go-back, headunit-update-goback@.service, /api/update/goback.
    - tools/rerelease.sh OLD NEW: publish an earlier release's files as a new version for every head unit.
    - Hudiy's built-in browser kept cached copies of the apps across updates (useWebCache), so an update
    could look like it did nothing or mix old and new files. The bridge now sends no-store for /apps,
    Hudiy's app a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
2026-11-05 Never show phrase names like nav.app_map; CarPlay tab always in Music
    Why 1.2.8 showed nav.app_map / nav.app_music ... on the map buttons: the new page came with an old,
    cached copy of the phrase list (i18n.json) that didn't have the button names yet, and the CarPlay
    part of Music came from a cached old music.js. Besides 1.2.9's no-cache fixes:
    - the phrase list and every app request are fetched with cache: no-store
    - a phrase that can't be found keeps the English text written in the page instead of its key name
    - Music: the CarPlay tab is always there (when the head unit is connected to Hudiy); with nothing
    playing from the phone it says so, instead of the tab being missing
    - the map's ph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
2026-11-05 Map building: OpenStreetMap download retries and resumes by itself
    A long download (the whole US is ~11.7 GB) can be cut by a reset or an SSL 'record layer failure';
    build-routing.py stopped there. It now retries up to 30 times, continuing from the last byte each
    time (If-Range: starts over only if Geofabrik published a newer file meanwhile), and running it again
    later still continues.
    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
2026-11-05 Map building on Windows: give Valhalla its DLLs (exit 3221225781)
    valhalla_build_tiles.exe exited at once with 3221225781 (0xC0000135, DLL not found): pyvalhalla's
    Windows wheel keeps its DLLs in site-packages/pyvalhalla.libs, which must be on PATH for the bundled
    programs (as pyvalhalla's own launcher does).
    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
2026-11-05 Voice packs: four original voices with their own lines, plus your own packs
    Settings > Driving > Voice picks who speaks the directions, with Play sample:
    - Standard (the espeak voice, every language) and four original personalities with their own wording:
    Neon Guide (calm, cool), Race Caller (high energy), Street Narrator (low, gritty), Cruise Control
    (laid back). They use Piper offline voices (Kristin, John: public domain; Joe: CC0; Northern
    English Male: CC BY-SA 4.0), downloaded on Wi-Fi with resume and kept across updates; until a model
    is there the pack speaks with its own espeak settings.
    - Your own packs: voices/README.md format (voice.json + optional recorded .wav clips), fro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
2026-11-05 Fix dead buttons and stale labels; talk to Hudiy correctly; lighter system
    Why buttons did nothing on the head unit:
    - Hudiy's API ignores everything a client sends before Hudiy answers its hello. Every message we
    sent (open the map at start, Back to map, live skin colors, reverse camera, phone subscriptions)
    went out right after hello and was dropped. send_once and HudiyLink now wait for the
    HelloResponse (and hold actions until then). Tests use a strict fake Hudiy that ignores early
    messages like the real one.
    - Hudiy's web view could still run old cached scripts with new pages (dead buttons, nav.app_map
    labels). App pages are now served with version-stamped script/style addresse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
    [fake_hudiy.py, hu-bridge.py, hu-hudiy-config.py, hu-hudiy-start.py]
2026-11-05 Release 1.2.12
    Button fixes, labels, performance
2026-11-05 Places: offline address book that learns where you go
    The map's star button opens Places:
    - Home, Work, Gym and School tiles: tap to drive there; set each to where the car is now or find it
    with search; the ... corner changes or removes it.
    - Saved places (from the destination sheet's star: save as Home / Work / Gym / School / Favorite).
    Old favorites carry over.
    - Places you go often: learned on the head unit from where you arrive and where the car starts
    from (where it was parked, so stops you never navigated to count too); offered for saving after
    3 visits, not once saved.
    - Recent destinations, one tap to drive there again.
    - Clear history (saved places stay); history older than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
2026-11-05 Search keyboard: Enter shows the address on the map
    An Enter key (where a keyboard has it; backspace moves to the top row) searches right away and shows
    the best match, an address first, on the map with its Go button, without waiting for or tapping a
    result. With no match it says so and stays open. A USB keyboard works too (typing, Backspace,
    Enter, Escape). Results show the address type and city on the destination card.
    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
2026-11-05 Search the whole state: ZIP / city typed first, Texas first, options when nothing matches
    - Address search looks at everything in the search data, not just near the
    map: a typed ZIP code, then a typed city, is searched first (most
    OpenStreetMap addresses have no city, so the ZIP / city's location counts)
    - No state typed: Texas results first; "..., Shreveport LA" prefers Louisiana
    - Estimated house numbers and the street fallback use the typed city too
    (every town has a Main St)
    - Business / place names: "walmart conroe" sorts around Conroe, Texas first,
    and no longer cuts off at 200 arbitrary matches
    - Nothing found: "No exact match. Did you mean:" lists similarly spelled
    streets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
    [hu-bridge.py, hu-search-check.py, hu_addr.py, test_address.py]
2026-11-05 Find country-road houses: your street before a far-away look-alike; Texas 911 house numbers
    Search ranking
    - Street type counts: Brandon Way is not Brandon Rd
    - The exact house, an estimate between neighbours and the street itself are
    scored together, so when OpenStreetMap has no number for a house, the road
    in the ZIP / city you typed beats a same-named street 250 km away
    - A typed ZIP / city weighs much more than distance; a confirmed city or ZIP
    on a result counts in its favour
    - hu-search-check.py lists all results and says when the street has no house
    numbers near the ZIP / city
    Missing house numbers (OpenStreetMap has few on country roads)
    - maps/add-addresses.py HEADUNIT_MAPS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
    [hu-search-check.py, hu_addr.py, test_add_addresses.py, test_address.py]
2026-11-06 Places: Address book button - scroll the phone's contacts, pick an address
    - Places panel > Address book: everyone with an address from the phone,
    A to Z with letter headers, scrolled with a finger; ABC / DEF / ... buttons
    on the side jump down the list
    - One address: straight to it on the map (Go / Cancel / save); more than one:
    pick Home / Work / ... from a list; an address that isn't in the offline
    map data is shown greyed and says so
    - Home / Work / Gym / School > "From the address book" sets that place to a
    contact's address
    - /api/contacts/book (bin/hu_contacts.py Contacts.book)
    Claude-Session: https://claude.ai/code/se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
2026-11-06 Contacts import: progress bars, a check + Import now in Developer; Hudiy notifications follow the skin
    Contact import
    - Progress while a phone shares its contacts: connecting (allow it on the
    phone) -> receiving n of total (PBAP GetSize, counted as they arrive) ->
    finding addresses on the map -> done / the reason it failed
    - Shown as a bar in Settings > Maps and Developer, and a slim chip at the top
    of the map; an open address book refreshes when it finishes
    - Settings > Developer > Phone contacts: Check lists each step (Bluetooth
    service, bluetooth group, bluez-obexd, each paired phone: connected /
    sharing contacts) and Import contacts now fetches from every paired phone
    whateve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
    [hu-bridge.py, hu-hudiy-theme.py, hu_contacts.py, test_contacts.py, test_hudiy_theme.py]
2026-11-06 Contacts import: whole phonebook transfer over one D-Bus connection
    Fixes 'Method "Select" with signature "ss" on interface
    "org.bluez.obex.PhonebookAccess1" doesn't exist': obexd ends a session as
    soon as the program that created it disconnects, and every busctl call was
    its own program, so the session was already gone by the next step.
    - ObexLink: one session-bus connection for CreateSession, Select, GetSize,
    PullAll, the transfer status and RemoveSession (jeepney, pure Python;
    dbus-python when that's what the Pi has)
    - Packages: python3-jeepney; the check reports a missing D-Bus library
    - Test: a stand-in obexd on a private session bus that ends a session when
    its creator disconnec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
    [fake_obexd.py, hu_contacts.py, test_contacts.py]
2026-11-06 Day and night skins: right place, right time, and Hudiy switches with them
    Where: with no GPS fix yet the sun was worked out for the middle of the map
    region - for the whole-US map that's the Pacific off Oregon, so the skins
    switched about two hours late in Texas. Now: GPS, else the last GPS position
    (kept on disk across restarts), else your Home place, else the time zone's
    populated middle, else the region only when it's one state.
    When: with no internet and no clock battery the Pi starts at the time it was
    switched off (last night). A GPS fix more than 2 minutes off now sets the
    time used for the skins (kept for a while when the GPS drops out); with a
    clock that says it's years ago the sk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
    [hu-bridge.py, hu-hudiy-theme.py, hu_sun.py, test_day_night.py, test_hudiy_theme.py]
2026-11-06 Contacts import: no GetSize, and a new session when the phone hangs up
    'UnknownObject: Method "PullAll" ... doesn't exist' means the session had
    already gone: the iPhone closed the contacts connection after Select /
    GetSize (it also does so right after asking "Allow ... to sync contacts?").
    - CreateSession -> Select -> PullAll only (no GetSize; the bar counts the
    contacts as they arrive instead of "n of total")
    - When the session vanishes part way (UnknownObject / UnknownMethod /
    disconnected) it's tried again with a fresh session, up to 3 times
    - If the phone hangs up every time: a plain-words message (unlock the phone,
    check Sync Contacts) plus the raw detail and the step it got to,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
    [fake_obexd.py, hu_contacts.py, test_contacts.py]
2026-11-06 Faster map and route: routing index, early warm-up, cached map code
    Route
    - The map builder packs Valhalla's tiles with index.bin first (the format of
    Valhalla's own valhalla_build_extract). Without it Valhalla reads every
    tile header across the multi-GB tar on the SD card before the first route;
    with it, one small read (60k tiles: 5x faster even from RAM, far more on
    an SD card). A rebuild that reuses an older tar adds it too.
    - The head unit gives a tar from an older build index.bin once, in the
    background at low priority (bin/hu_valhalla_tar.py; rewritten next to
    itself, swapped in when complete, left alone without room); Settings >
    Maps shows "preparing for a fast start: n%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
    [hu-bridge.py, hu_valhalla_tar.py, test_routing_speed.py]
2026-11-06 Quicker, seamless start: key-on to map
    Boot (setup.d/22-fastboot.sh)
    - Firmware: no 1 s boot_delay, no rainbow screen, full CPU speed for the first
    30 s, no probing for a ribbon-cable camera or display (the backup camera is
    USB; the touch display has its own overlay)
    - Linux: no boot text, logo or blinking cursor on the screen
    - linger: the bridge, voices and audio start with the system instead of after
    the desktop logs in, so they're ready when Hudiy and the map open (first
    boot no longer turns it off after installing Hudiy)
    - The desktop behind Hudiy: the boot image (or black) as its background and
    the taskbar hidden: boot image -> map with no Raspberry Pi desktop between
    Deskto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
    [hu-bridge.py, hu-desktop-start.py, hu-hudiy-start.py, hu-hudiy-theme.py, hu_boot.py, test_boot.py]
2026-11-06 Make the new fast-start stage and desktop-start script executable
    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
